swzhangf/AERIS-10-Open-Source-Pulse-Linear-Frequency-Modulated-Phased-Array-Radar/4_Schematics and Boards Layout/4_7_Production Files/PCBWay_Impedance_Note_RO4350B_h0p102mm.pdf

# Controlled Impedance Note — RO4350B (h = 0.102

mm)

## Stackup Details

- Material: Rogers RO4350B
- Dielectric constant (Design Dk): 3.66 (diff-phase method)
- Dielectric constant (Process Dk): 3.48 ± 0.05 (IPC clamped)
- Dielectric thickness (h): 0.102 mm
- Copper thickness: 35 µm base, ~40–45 µm finished after plating
- Solder mask: None (maskless RF traces over air)
- Reference: Continuous ground plane directly beneath RF layer

## Targets

Differential pair (LVDS) | Zdiff = 100 Ω ± 8%
Single-ended reference | Z0 = 50 Ω ± 10%

## Starting Geometry (maskless microstrip)

Values are starting points for PCBWay CAM to field-solve and tune with coupons.

Assumption | 50 Ω microstrip (w, mm) | 100 Ω diff pair (w, mm) | 100 Ω diff pair (s edge-edge, mm)
Process Dk = 3.48 | 0.204 | 0.204 | 0.26
Design Dk = 3.66 | 0.195 | 0.195 | 0.26

## Alternate Option (keep w = 0.204 mm; adjust gap for Design Dk)

Assumption | w (mm) | s edge-edge (mm) | Expected Zdiff
Design Dk = 3.66 | 0.204 | 0.30 | ≈ 100–102 Ω

## Routing Rules

- Continuous reference plane; no splits/slots beneath the pair
- Point-to-point routing; no stubs or tees; equal via count per leg
- Intra-pair length match: ≤ 1–2 mm for 10.5 GHz RF; ≤ 5 mm for LVDS clocks
- No same-layer ground pour near the pair unless re-solved for CPWG
- If via fencing is used: via-center to outer trace edge ≈ 0.5 mm; pitch ≤ 1.0 mm; symmetric on both sides
- Receiver termination: 100 Ω differential (omit external if receiver provides internal 100 Ω)

## Coupon/Test Notes

- Provide impedance coupons for both 50 Ω microstrip and 100 Ω differential pair
- PCBWay may tune w by ±0.02–0.04 mm and/or s by ±0.03–0.05 mm to hit targets
- Return as-built geometry values (w, s) in the fab report
