swzhangf/AERIS-10-Open-Source-Pulse-Linear-Frequency-Modulated-Phased-Array-Radar/4_Schematics and Boards Layout/4_6_Schematics/Antennas/Patch/8x16/Design 8x16 at 10.5GHz.docx

Design 8x16 at 10.5 GHz

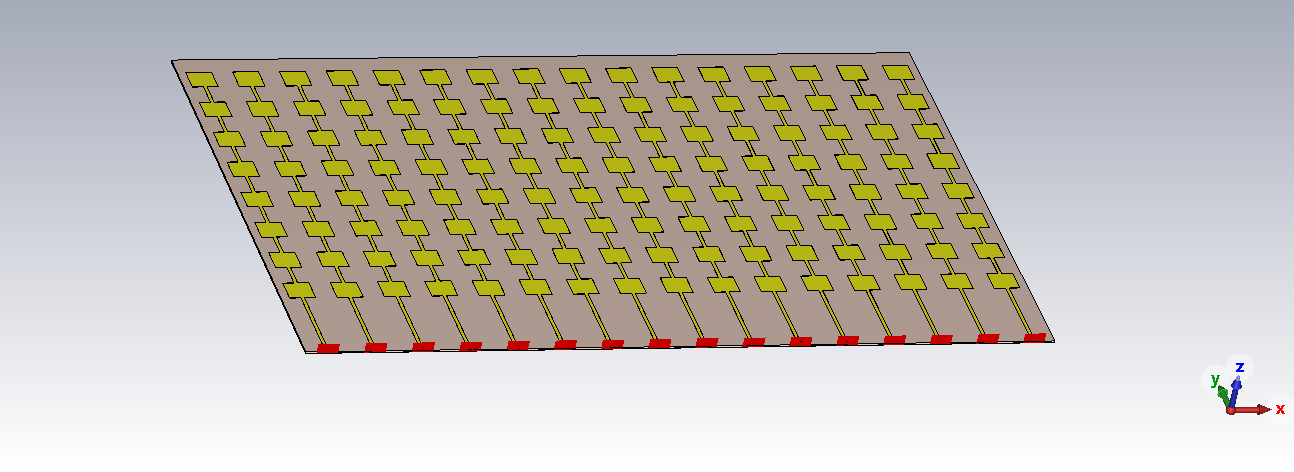
[picture p15: figure]

Working Frequency 10.5 GHz

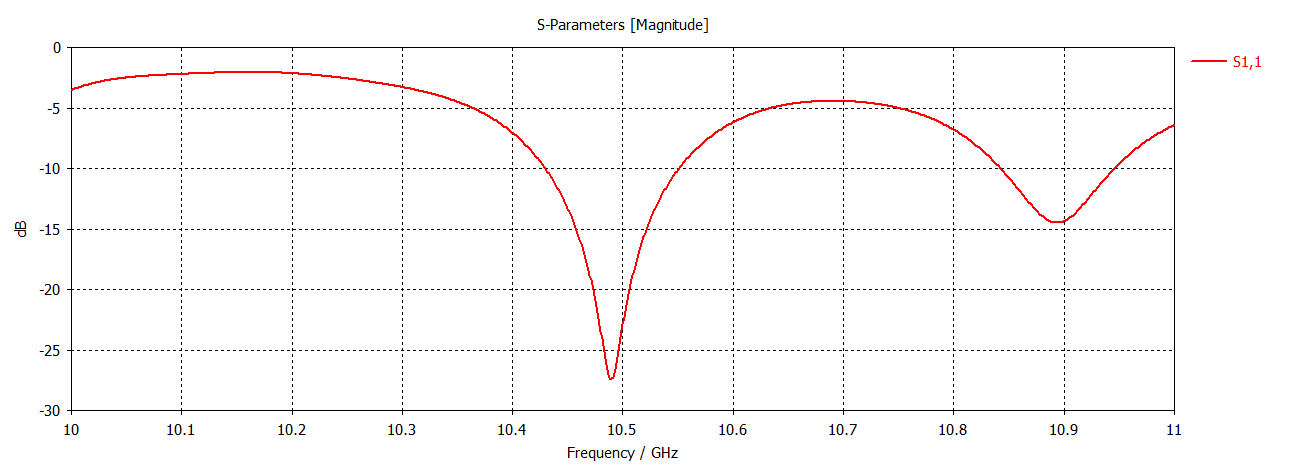
[picture p16: figure]

Gain 24.3 dBi

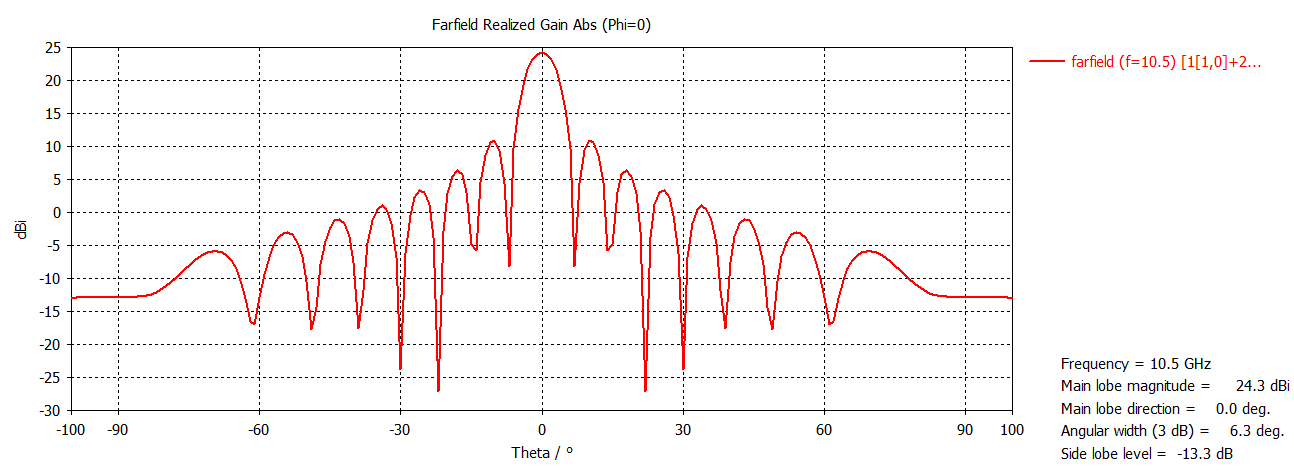
[picture p17: figure]
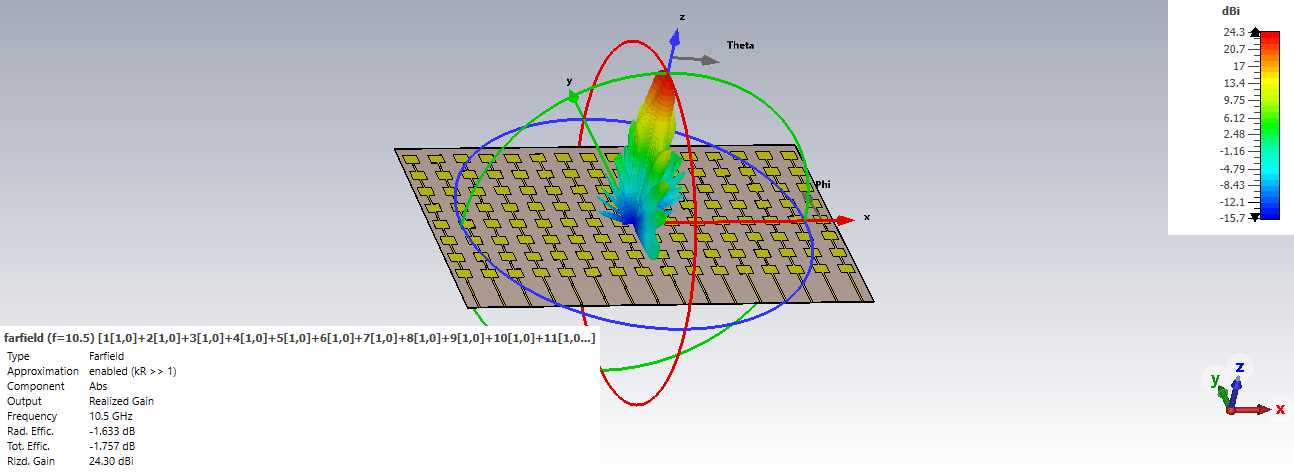
[picture p18: figure]
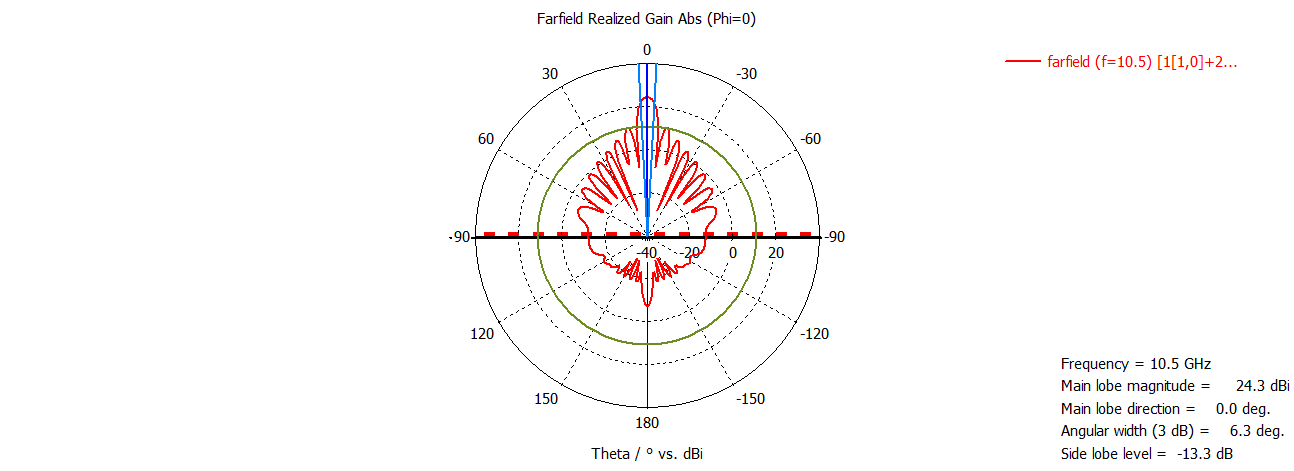
[picture p19: figure]
