swzhangf/AERIS-10-Open-Source-Pulse-Linear-Frequency-Modulated-Phased-Array-Radar/5_Simulations/Sim_BPF_Te_100um/Sim_BPF_Te_100um.pdf

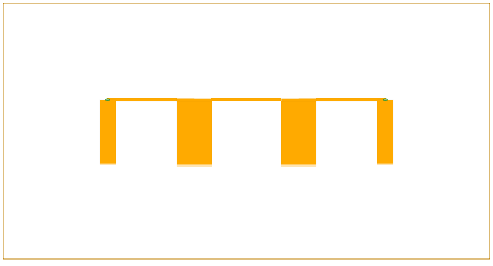
[picture p20: figure]
