swzhangf/AERIS-10-Open-Source-Pulse-Linear-Frequency-Modulated-Phased-Array-Radar/4_Schematics and Boards Layout/4_4_Board Stack-up/Stack_Hybrid.png

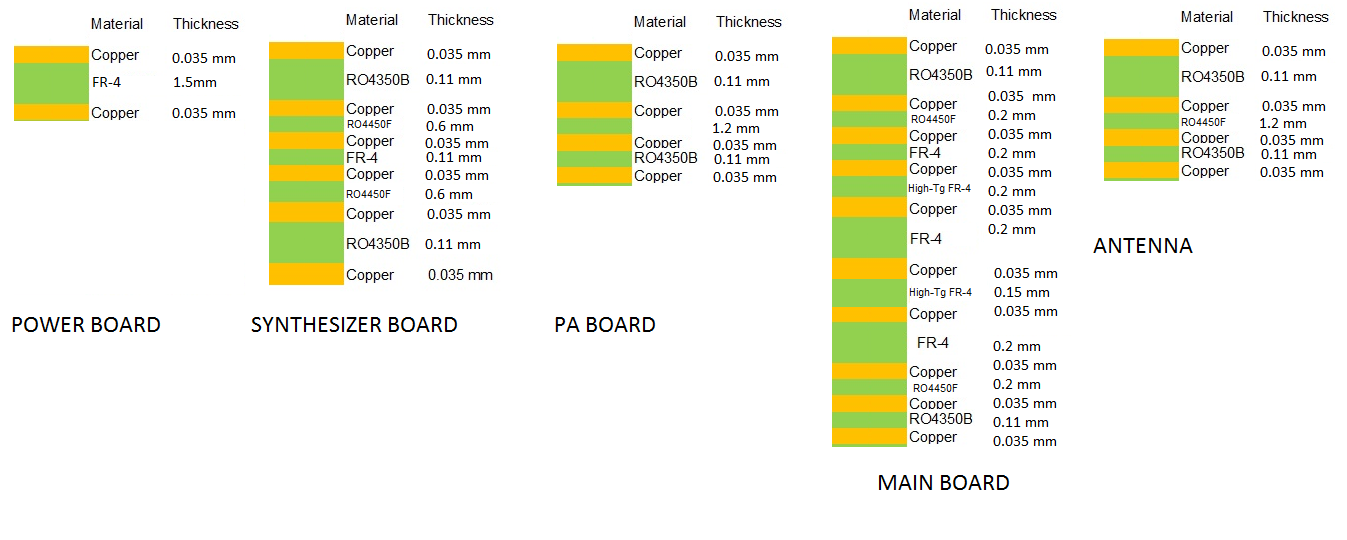
4_Schematics and Boards Layout/4_4_Board Stack-up/Stack_Hybrid.png
