swzhangf/AERIS-10-Open-Source-Pulse-Linear-Frequency-Modulated-Phased-Array-Radar/4_Schematics and Boards Layout/4_6_Schematics/Stack_Hybrid.png

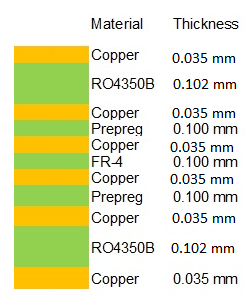
4_Schematics and Boards Layout/4_6_Schematics/Stack_Hybrid.png
