swzhangf/AERIS-10-Open-Source-Pulse-Linear-Frequency-Modulated-Phased-Array-Radar/5_Simulations/array_pattern_heatmap.png

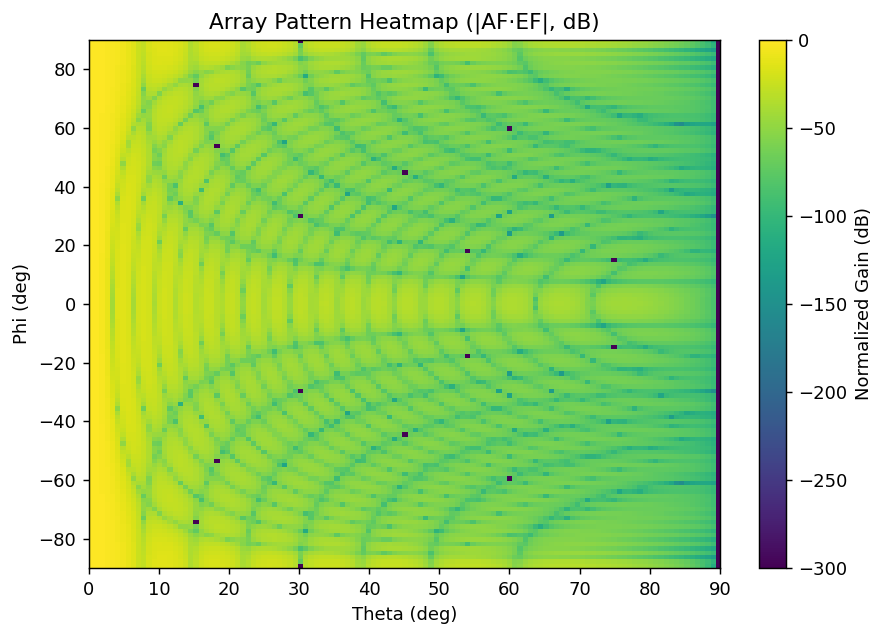
5_Simulations/array_pattern_heatmap.png
