swzhangf/AERIS-10-Open-Source-Pulse-Linear-Frequency-Modulated-Phased-Array-Radar/5_Simulations/H_plane_cut.png

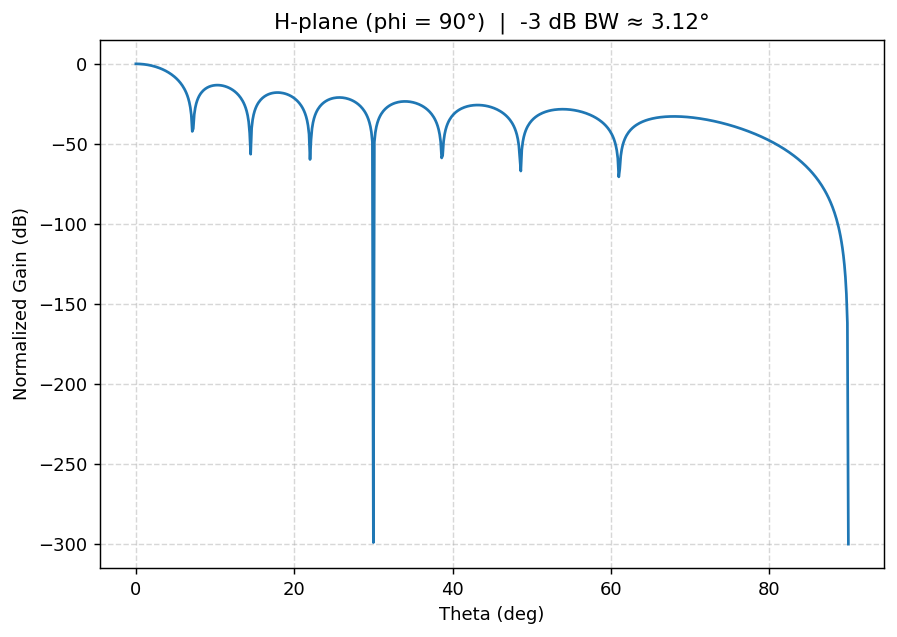
5_Simulations/H_plane_cut.png
