swzhangf/AERIS-10-Open-Source-Pulse-Linear-Frequency-Modulated-Phased-Array-Radar/8_Utils/3fb1dabf-2c6d-4b5d-b471-48bc461ce914.jpg

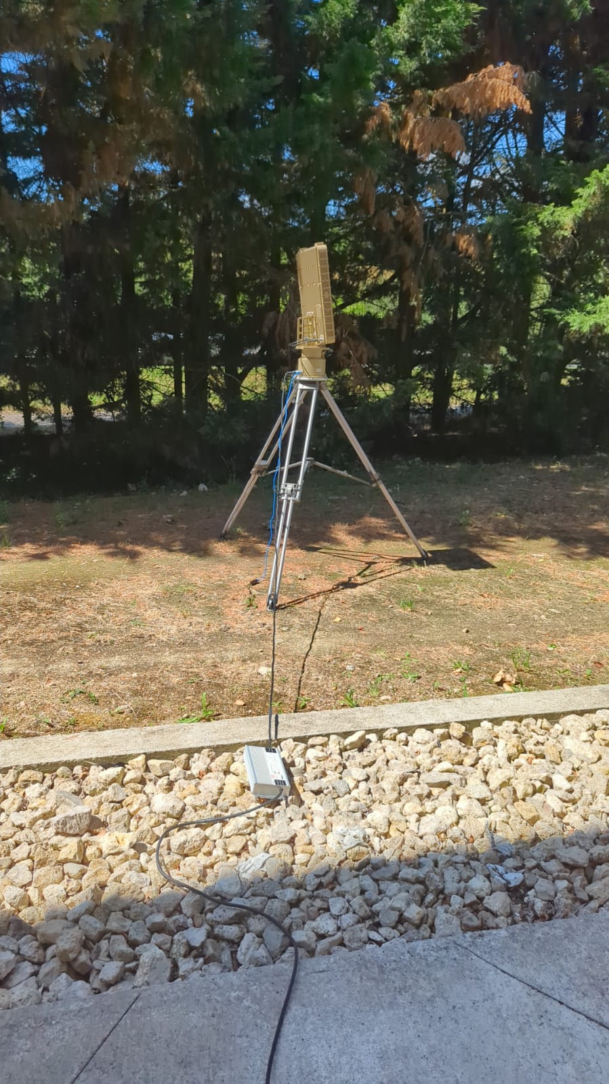
8_Utils/3fb1dabf-2c6d-4b5d-b471-48bc461ce914.jpg
