swzhangf/AERIS-10-Open-Source-Pulse-Linear-Frequency-Modulated-Phased-Array-Radar/8_Utils/b79a6fe3-5abf-473d-b3e2-178e6a9cf4da - Copie.jpg

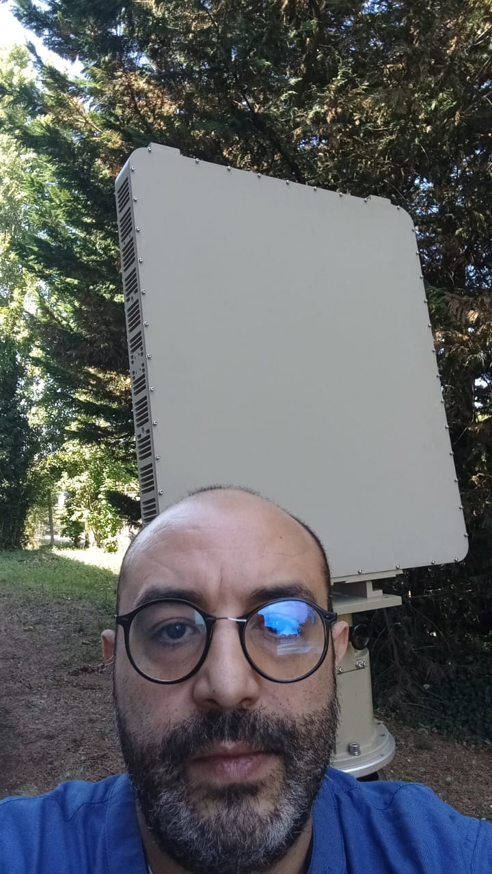
8_Utils/b79a6fe3-5abf-473d-b3e2-178e6a9cf4da - Copie.jpg
