swzhangf/AERIS-10-Open-Source-Pulse-Linear-Frequency-Modulated-Phased-Array-Radar/8_Utils/PCBWAY.jpg

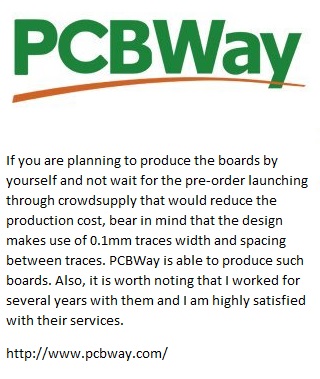
8_Utils/PCBWAY.jpg
