swzhangf/AERIS-10-Open-Source-Pulse-Linear-Frequency-Modulated-Phased-Array-Radar/4_Schematics and Boards Layout/4_7_Production Files/Gerber_PA/BOM.xlsx

Qty | Value | Device | Package | Parts | Description | MANUFACTURER_PART_NUMBER | MPN | OC_FARNELL | OC_NEWARK
1 |  | AK300/2 | AK300/2 | 22V | CONNECTOR |  |  | unknown | unknown
6 | 0.1µF | C-EUC0402 | C0402 | C2, C3, C6, C7, C8, C9 | CAPACITOR, European symbol
6 | 0R | R-EU_R0402 | R0402 | R2, R3, R5, R7, R8, R9 | RESISTOR, European symbol
1 | 0R | R-EU_R0603 | R0603 | R6 | RESISTOR, European symbol
2 | 10R | R-EU_R0402 | R0402 | R1, R4 | RESISTOR, European symbol
3 | 10µF | C-EUC1206 | C1206 | C1, C4, C5 | CAPACITOR, European symbol
2 | 142-0731-211 | 142-0731-211 | 1420731211 | J1, J2 | SMA Connector Jack, Female Socket 50 Ohms Through Hole Solder | 142-0731-211
1 | 22-23-2021 | 22-23-2021 | 22-23-2021 | X2 | .100 (2.54mm) Center Header - 2 Pin" |  | 22-23-2021 | 1462926 | 25C3832
1 | 22-23-2031 | 22-23-2031 | 22-23-2031 | X3 | .100 (2.54mm) Center Header - 3 Pin" |  | 22-23-2031 | 1462950 | 30C0862
1 | 5mR | WSL2816R1000FEH | WSL2816_VIS | R10 |  | WSL2816R1000FEH
1 | QPA2962_B | QPA2962_B | QPA2962_B | U$1
