swzhangf/AERIS-10-Open-Source-Pulse-Linear-Frequency-Modulated-Phased-Array-Radar/4_Schematics and Boards Layout/4_7_Production Files/Gerber_PowerBoard/BOM.xlsx

Sheet: Feuil1
DESIGNATOR | Qty | *Mfg Part # | Value | Device | Package | Description | DESCRIPTION |  |  |  |  |  |  |  |  | unknown | unknown | 16
X1 | 1 |  |  | AK300/2 | AK300/2 | CONNECTOR |  |  |  |  |  |  |  |  |  | unknown | unknown | 3
SV1 | 1 |  |  | MA10-2 | MA10-2 | PIN HEADER |  |  |  |  |  |  |  |  |  |  |  | 88 |  | C
C1, C6, C12, C18, C29, C30, C36, C42, C54, C60, C66, C71, C76, C77, C83, C89, C109, C119, C129, C144, C154 | 21 |  | 0.1µF | C-EUC0805 | C0805 | CAPACITOR, European symbol |  |  |  |  |  |  |  |  |  |  |  | 45 |  | R
R2, R4, R6, R8, R10, R12, R14, R16, R18, R20, R22, R24, R26, R28, R30, R32, R34, R36, R38, R40, R42, R44, R46, R48, R50, R52, R56 | 27 |  | 10k | R-EU_M0805 | M0805 | RESISTOR, European symbol |  |  |  |  |  |  |  |  |  |  |  | 73 |  | C
C150, C152, C160, C162 | 4 |  | 10nF | C-EUC0603 | C0603 | CAPACITOR, European symbol |  |  |  |  |  |  |  |  |  |  |  | 73 |  | C
C151, C153, C161, C163 | 4 |  | 10µF | C-EUC0603 | C0603 | CAPACITOR, European symbol |  |  |  |  |  |  |  |  |  |  |  | 88 |  | C
C4, C5, C9, C10, C15, C16, C21, C22, C24, C25, C28, C33, C34, C39, C40, C45, C46, C50, C51, C52, C53, C57, C58, C63, C64, C69, C70, C74, C75, C80, C81, C86, C87, C92, C93, C94, C95, C108, C112, C113, C114, C115, C118, C122, C123, C124, C125, C128, C132, C133, C134, C135, C138, C139, C140, C143, C147, C148, C157, C158 | 60 |  | 10µF | C-EUC0805 | C0805 | CAPACITOR, European symbol |  |  |  |  |  |  |  |  |  |  |  | 45 |  | R
R54, R58 | 2 |  | 11.5k | R-EU_M0805 | M0805 | RESISTOR, European symbol |  |  |  |  |  |  |  |  |  |  |  | 45 |  | R
R9, R35, R43, R47 | 4 |  | 12k | R-EU_M0805 | M0805 | RESISTOR, European symbol |  |  |  |  |  |  |  |  |  |  |  | 45 |  | R
R3 | 1 |  | 13.7k | R-EU_M0805 | M0805 | RESISTOR, European symbol |  |  |  |  |  |  |  |  |  |  |  | 88 |  | C
C26, C27, C106, C107, C116, C117, C126, C127, C136, C137, C141, C142 | 12 |  | 1µF | C-EUC0805 | C0805 | CAPACITOR, European symbol
U$1, U$2 | 2 |  | 2.2µH | POWER_INDUCTOR | IND_VLP8040T-1R0N_TDK |  |  |  |  |  | MOLEX |  |  |  | 22-23-2021 | 1462926 | 25C3832 | 40
X2, X3, X4, X5, X6, X7, X8, X9, X10, X11, X12, X13, X14, X15, X16, X17, X18, X19, X20, X21, X22, X23, X24, X25, X26, X27, X28, X29, X30, X31, X32, X33, X34, X35, X36 | 35 |  | 22-23-2021 | 22-23-2021 | 22-23-2021 | .100 (2.54mm) Center Header - 2 Pin" |  |  |  |  |  |  |  |  |  |  |  | 73 |  | C
C2, C3, C7, C8, C11, C13, C14, C17, C19, C20, C23, C31, C32, C35, C37, C38, C41, C43, C44, C47, C48, C49, C55, C56, C59, C61, C62, C65, C67, C68, C72, C73, C78, C79, C82, C84, C85, C88, C90, C91, C110, C111, C120, C121, C130, C131, C145, C146, C149, C155, C156, C159 | 52 |  | 22µF | C-EUC0603 | C0603 | CAPACITOR, European symbol |  |  |  |  |  |  |  |  |  |  |  | 45 |  | R
R49 | 1 |  | 23.4k | R-EU_M0805 | M0805 | RESISTOR, European symbol |  |  |  |  |  |  |  |  |  |  |  | 45 |  | R
R39 | 1 |  | 2k | R-EU_M0805 | M0805 | RESISTOR, European symbol |  |  |  |  |  |  |  |  |  |  |  | 45 |  | R
R1 | 1 |  | 3.09k | R-EU_M0805 | M0805 | RESISTOR, European symbol
U$3, U$4, U$5, U$6, U$7, U$8, U$9, U$10, U$11, U$12, U$13, U$14, U$15, U$16, U$17, U$18, U$19, U$20, U$21 | 19 |  | 3.3µH | POWER_INDUCTOR | IND_VLP8040T-1R0N_TDK |  |  |  |  |  |  |  |  |  |  |  |  | 45 |  | R
R5, R7, R11, R13, R15, R19 | 6 |  | 32.2k | R-EU_M0805 | M0805 | RESISTOR, European symbol |  |  |  |  |  |  |  |  |  |  |  | 45 |  | R
R21 | 1 |  | 34.8k | R-EU_M0805 | M0805 | RESISTOR, European symbol |  |  |  |  |  |  |  |  |  |  |  | 45 |  | R
R53, R57 | 2 |  | 35.7k | R-EU_M0805 | M0805 | RESISTOR, European symbol |  |  |  |  |  |  |  |  |  |  |  | 45 |  | R
R17, R23, R25, R27, R29, R31, R37, R41, R45, R51, R55 | 11 |  | 56.2k | R-EU_M0805 | M0805 | RESISTOR, European symbol |  |  |  |  |  |  |  |  |  |  |  | 45 |  | R
R33 | 1 |  | 61.9k | R-EU_M0805 | M0805 | RESISTOR, European symbol |  |  | Analog Devices Inc | ADM7151ACPZ-04-R7
U5, U23, U25, U27, U29, U30 | 6 |  | ADM7151ACPZ-04-R7 | ADM7151ACPZ-04-R7 | CP_8_11_ADI |  | 800 mA Ultralow Noise, High PSRR, RF Linear Regulator |  |  | LM2662MX/NOPB |  | Texas Instruments |  |  |  |  |  |  |  |  | LM2662M
U18, U19, U20, U21, U22 | 5 |  | LM2662MX/NOPB | LM2662MX/NOPB | M08A |  |  | 1.5mm | KEMET | T521W476M020ATE045 |  |  | 80-T521W476M20ATE045 | https://www.mouser.co.uk/ProductDetail/KEMET/T521W476M020ATE045?qs=Ad%252Bh9aq9FyVtchBw1jwoFA%3D%3D
C96, C97, C98, C99, C100, C101, C102, C103, C104, C105 | 10 |  | T521W476M020ATE045 | T521W476M020ATE045 | T521W | T521, Tantalum, Polymer Tantalum, Commercial Grade, 47 uF, 20%, 20 VDC, 105C, -55C, 105C, SMD, Polymer, Molded, Low Profile/ESR, NonCombustible, 2,000 Hrs, 9 % , 45 mOhms, 94 uA, 222.95 mg, 7343, 1.4mm, Height Max = 1.5mm, 1000, 52 Weeks | T521, Tantalum, Polymer Tantalum, Commercial Grade, 47 uF, 20%, 20 VDC, 105C, -55C, 105C, SMD, Polymer, Molded, Low Profile/ESR, NonCombustible, 2,000 Hrs, 9 % , 45 mOhms, 94 uA, 222.95 mg, 7343, 1.4mm, Height Max = 1.5mm, 1000, 52 Weeks |  | Texas Instruments | TPS562208DDCT |  |  |  |  |  |  |  |  | RefDes |  | TYPE
U1, U2, U3, U4, U6, U7, U8, U9, U10, U11, U12, U13, U14, U15, U16, U17, U24, U26, U28, U31, U33 | 21 |  | TPS562208DDCT | TPS562208DDCT | DDC0006A_N |  | 4.5 V to 17 V input, 2 A output, synchronous step-down converter in FCCM mode 6-SOT-23-THIN -40 to 125 |  | Texas Instruments | TPS7A8300RGRR
U32, U34 | 2 |  | TPS7A8300RGRR | TPS7A8300RGRR | RGR20_2P05X2P05_TEX |  | 2-A, low-VIN, low-2-A, low-VIN, low-noise, ultra-low-dropout voltage regulator with power good wi 20-VQFN -40 to 125

Sheet: Feuil2
Item # | *Designator | *Qty | Manufacturer | *Mfg Part # | Description / Value | *Package/Footprint | Type | Your Instructions / Notes | HEIGHT | MANUFACTURER_NAME | MANUFACTURER_PART_NUMBER | MF | MFR_NAME | MOUSER_PART_NUMBER | MOUSER_PRICE-STOCK | MPN | OC_FARNELL | OC_NEWARK | POPULARITY | REFDES | SPICEPREFIX | TYPE
