swzhangf/AERIS-10-Open-Source-Pulse-Linear-Frequency-Modulated-Phased-Array-Radar/5_Simulations/Sim_BPF_Te_100um/Drawing1.dxf

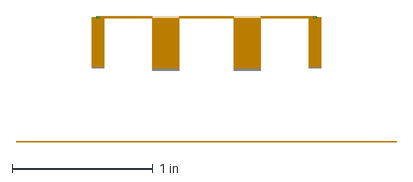
[picture p33: CAD file, 2026-04-20]
5_Simulations/Sim_BPF_Te_100um/Drawing1.dxf
2.70 x 0.892 in
