swzhangf/AERIS-10-Open-Source-Pulse-Linear-Frequency-Modulated-Phased-Array-Radar/(list of files, cad)

Other CAD files:
4_Schematics and Boards Layout/4_6_Schematics/Antennas/Waveguide/DFSWA.dwg
8_Utils/Mechanical_Drawings/Enclosure.dwg
8_Utils/Mechanical_Drawings/RADAR_V1.dwg
