swzhangf/AERIS-10-Open-Source-Pulse-Linear-Frequency-Modulated-Phased-Array-Radar/4_Schematics and Boards Layout/4_6_Schematics/Antennas/Waveguide/Dielectric_Filled_Waveguide_Array_Spec.docx

# Dielectric-Filled Waveguide Phased Array Antenna — Specifications & Deliverables

Date: 2025-08-13 | Version: 1.0 | Prepared by: Nawfal MOTII

# Project Overview

High-power, dielectric-filled rectangular waveguide phased array antenna for X-band operation. The array comprises 16 parallel waveguide columns, each with 32 longitudinal slots (travelling wave architecture), separated at λ₀/2 to enable ±60° electronic steering across columns. High purity alumina (Al₂O₃, 99.5–99.8%) is used as the dielectric fill to reduce cross section while maintaining low loss and robust thermal performance.

# Key Specifications (Customer Inputs)

Operating Frequency (f₀) | 10.5 GHz
Array Topology | 16 columns × 32 slots/column (travelling‑wave, terminated)
Inter‑column Pitch (dᵧ) | λ₀/2 ≈ 14.28 mm at 10.5 GHz
Dielectric Material | High‑purity alumina (Al₂O₃, 99.5–99.8%)
Microwave Power | 15 W per column (total 240 W)
Feed Type | 16 SMA connectors (one per waveguide column)
Total Gain (broadside) | ≥ 31 dBi
Electronic Steering Range | ±60° (across waveguide columns)

# Derived / Recommended Specifications

Free‑space wavelength (λ₀) | 28.55 mm
Guide cross‑section (internal) | a = 8.5 mm, b = 3.5 mm (alumina‑filled)
TE₁₀ cutoff (f_c10) | 5.63 GHz
Higher-order cutoffs | TE₂₀ ≈ 11.27 GHz, TE₀₁ ≈ 13.68 GHz (both > 10.5 GHz)
Guide wavelength (λ_g) | 10.81 mm
Slot spacing (s = λ_g/2) | 5.40 mm
Starter slot length (L_s≈0.47λ_g) | 5.08 mm
Column length (32 slots incl. margins) | 0.173 m
Panel height (16 columns) | 0.223 m
Geometric aperture (A=L·H) | 0.0385 m²
Ideal directivity | 27.73 dBi
EIRP at 240 W, G=31 dBi | 54.8 dBW

# Electrical Performance Targets

- Return loss (S₁₁) per column: ≤ −12 dB at 10.5 GHz; ≤ −10 dB across 10.25–10.75 GHz.
- Gain (boresight): ≥ 31 dBi; design goal 31–32 dBi with Taylor −25 dB taper.
- Sidelobe level (broadside, both principal planes): ≤ −23 dB (goal ≤ −25 dB).
- Cross‑polarization: ≤ −20 dB within main beam (goal ≤ −25 dB).
- Scan performance across columns: continuous scan to ±60°; scan loss ≤ 2 dB at 60°.
- Polarization: Linear
- Input impedance per column: nominal 50 Ω at feed; probe placed ≈ λ_g/4 from short.
- Phase shifter resolution recommendation: ≤ 5.6° LSB (≈ 1° angle steps near boresight).

# Mechanical & Materials

- Waveguide body: aluminum or copper alloy split-block; internal a=8.5 mm, b=3.5 mm (dielectric-filled).
- Dielectric: high-purity alumina (Al₂O₃ 99.5–99.8%); full fill or partial sidewall slabs (per EM optimization).
- Connectors: 16× SMA female bulkhead (power rated at X band); one per column.
- Feed geometry: coax probe feed located ≈ λ_g/4 from shorted back wall, centered (or tuned offset) in y.
- Manufacturing tolerances: slot length ±0.05 mm; slot offset ±0.03 mm; slot center position ±0.05 mm; flatness per length ≤ 0.05 mm/100 mm.
- Surface finish: Ra ≤ 1.6 µm in the RF volume; deburr and radius sharp edges.
- Optional plating: silver or electroless nickel (ENIG) as agreed; document any thickness effects.
- Optional pressurization: dry air/N₂ up to 1–2 bar for breakdown margin (include seals if required).

# Thermal & Power

- Per column CW power: 15 W; total 240 W distributed across 16 columns.
- Continuous operation over ambient −20 °C to +60 °C (goal; to be confirmed).
- Internal temperature rise limited such that dielectric and adhesives remain within ratings (supplier datasheets).

# Interfaces & Control

- RF inputs: 16 SMA female bulkhead connectors, 50 Ω.
- Beam steering: progressive phase per column (external phase shifters on customer PCB).
- Reference coordinate system and connector numbering: as per final assembly drawing.

# Verification & Test (Acceptance Criteria)

- VNA measurements: S₁₁ per column and inter column over 9–12 GHz; provide plots and Touchstone (.sNp/.s2p) and CSV.
- Anechoic chamber: boresight gain and 2D patterns at 10.3/10.5/10.7 GHz; provide polar plots and CSV.
- Scan patterns: measured principal plane cuts at θ = 0°, ±30°, ±45°, ±60° with specified phase sets; CSV exports.
- Near field to far field transform acceptable if chamber size limits; include processing details.
- Power run: operate at 15 W/column CW for 30 minutes; verify no arcing, no detuning beyond specs.
- Dimensional inspection: slot length/offset/spacing, column pitch, connector positions per tolerances.

# Deliverables

- Final 3D CAD: STEP (.stp) and/or Parasolid (.x_t); panel assembly and split‑block parts.
- 2D manufacturing drawings (PDF + native CAD) with full dimensions and tolerances.
- DXF/DWG: slot patterns, connector hole locations, and any gasket/seal cutouts.
- Materials list / BOM: metals, dielectric (alumina), fasteners, plating, adhesives, gaskets, finishes.
- EM simulation package: project files (HFSS/CST), simulation settings, and parametric studies.
- Simulation results: • S‑parameters 9–12 GHz (plots + Touchstone + CSV) • Input impedance 9–12 GHz (plots + CSV) • Surface current distributions at 10.5 GHz (images + data) • Far‑field patterns at θ = 0°, ±30°, ±45°, ±60° (plots + CSV)
- Slot synthesis tables: per‑column slot centers, lengths, and offsets (CSV).
- Assembly instructions and tuning plan (if any trim adjustments are foreseen).
- Qualification / acceptance test report with measured data and comparison to targets.
