swzhangf/AERIS-10-Open-Source-Pulse-Linear-Frequency-Modulated-Phased-Array-Radar/5_Simulations/Fencing/via_fence_setup_pitch_offset.png

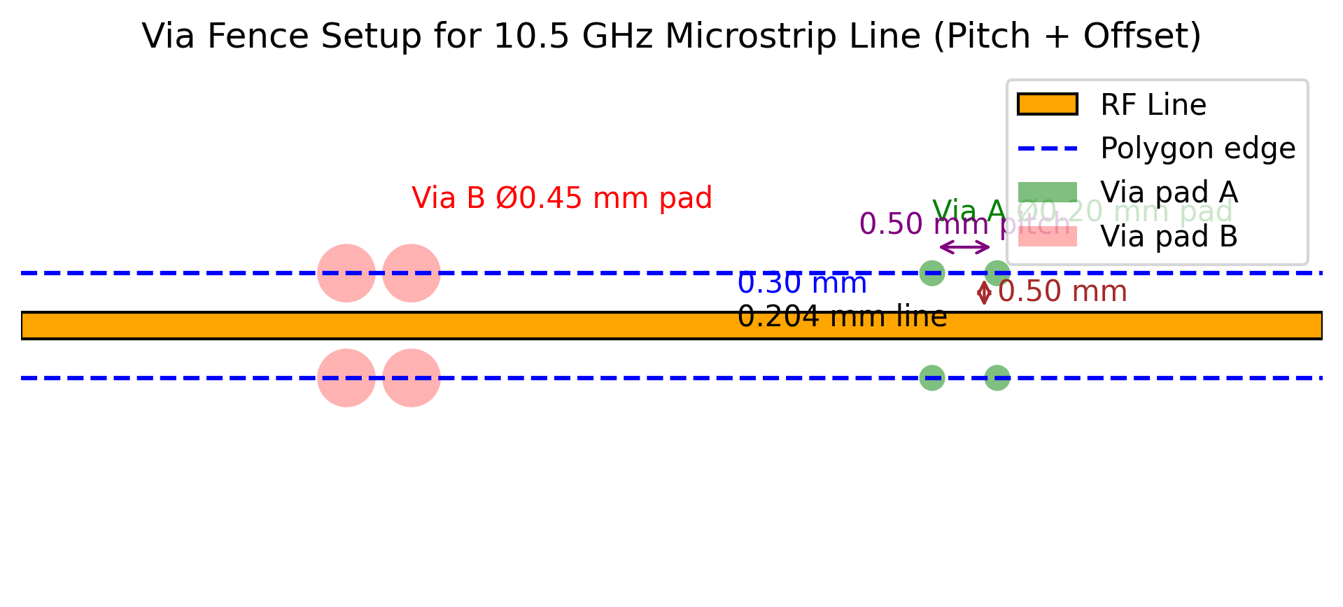
5_Simulations/Fencing/via_fence_setup_pitch_offset.png
