swzhangf/AERIS-10-Open-Source-Pulse-Linear-Frequency-Modulated-Phased-Array-Radar/8_Utils/Python/small_test_radar_data.csv

timestamp_ns | chirp_number | chirp_type | sample_index | I_value | Q_value | magnitude_squared
0 | 0 | LONG | 0 | -4 | 2 | 31
2 | 0 | LONG | 1 | 3 | -3 | 19
4 | 0 | LONG | 2 | 0 | 0 | 0
6 | 0 | LONG | 3 | -3 | 0 | 16
8 | 0 | LONG | 4 | -1 | -6 | 41
10 | 0 | LONG | 5 | 0 | 6 | 41
12 | 0 | LONG | 6 | -2 | 0 | 4
14 | 0 | LONG | 7 | -5 | 4 | 50
16 | 0 | LONG | 8 | 4 | -2 | 26
18 | 0 | LONG | 9 | 0 | -1 | 2
20 | 0 | LONG | 10 | 3 | 1 | 14
22 | 0 | LONG | 11 | 2 | -2 | 12
24 | 0 | LONG | 12 | -1 | 0 | 2
26 | 0 | LONG | 13 | 0 | -1 | 1
28 | 0 | LONG | 14 | -2 | 0 | 5
30 | 0 | LONG | 15 | 0 | 5 | 26
32 | 0 | LONG | 16 | -1 | 1 | 6
34 | 0 | LONG | 17 | -4 | 0 | 23
36 | 0 | LONG | 18 | 0 | 0 | 0
38 | 0 | LONG | 19 | -3 | -4 | 32
40 | 0 | LONG | 20 | -2 | 0 | 5
42 | 0 | LONG | 21 | 0 | -4 | 18
44 | 0 | LONG | 22 | -2 | 0 | 4
46 | 0 | LONG | 23 | 1 | -3 | 14
48 | 0 | LONG | 24 | 1 | -1 | 5
50 | 0 | LONG | 25 | 3 | 3 | 26
52 | 0 | LONG | 26 | 0 | 3 | 10
54 | 0 | LONG | 27 | -4 | -2 | 27
56 | 0 | LONG | 28 | 2 | 0 | 5
58 | 0 | LONG | 29 | 0 | -5 | 25
60 | 0 | LONG | 30 | -2 | 1 | 8
62 | 0 | LONG | 31 | 0 | 0 | 0
64 | 0 | LONG | 32 | -3 | -3 | 22
66 | 0 | LONG | 33 | 0 | 0 | 1
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
