swzhangf/AERIS-10-Open-Source-Pulse-Linear-Frequency-Modulated-Phased-Array-Radar/8_Utils/Python/test_radar_data.csv

timestamp_ns | chirp_number | chirp_type | sample_index | I_value | Q_value | magnitude_squared
0 | 0 | LONG | 0 | -15 | 16 | 499
2 | 0 | LONG | 1 | -12 | 17 | 484
4 | 0 | LONG | 2 | 0 | 9 | 94
6 | 0 | LONG | 3 | -12 | -8 | 228
8 | 0 | LONG | 4 | -2 | -4 | 26
10 | 0 | LONG | 5 | -10 | -2 | 124
12 | 0 | LONG | 6 | -4 | -13 | 195
14 | 0 | LONG | 7 | -3 | -5 | 44
16 | 0 | LONG | 8 | -12 | 14 | 356
18 | 0 | LONG | 9 | -3 | -5 | 40
20 | 0 | LONG | 10 | 0 | -8 | 76
22 | 0 | LONG | 11 | -11 | 26 | 846
24 | 0 | LONG | 12 | -7 | 1 | 53
26 | 0 | LONG | 13 | -10 | 10 | 216
28 | 0 | LONG | 14 | 3 | -3 | 27
30 | 0 | LONG | 15 | 21 | 8 | 517
32 | 0 | LONG | 16 | 17 | 3 | 317
34 | 0 | LONG | 17 | 15 | -5 | 279
36 | 0 | LONG | 18 | 29 | -1 | 886
38 | 0 | LONG | 19 | -16 | 0 | 268
40 | 0 | LONG | 20 | -6 | -9 | 129
42 | 0 | LONG | 21 | 0 | 0 | 0
44 | 0 | LONG | 22 | -5 | 1 | 30
46 | 0 | LONG | 23 | 12 | 11 | 300
48 | 0 | LONG | 24 | 10 | 1 | 116
50 | 0 | LONG | 25 | -5 | -14 | 255
52 | 0 | LONG | 26 | -2 | 3 | 18
54 | 0 | LONG | 27 | 0 | 11 | 135
56 | 0 | LONG | 28 | 9 | 19 | 466
58 | 0 | LONG | 29 | 15 | 6 | 280
60 | 0 | LONG | 30 | -13 | 4 | 187
62 | 0 | LONG | 31 | 2 | -8 | 76
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
