swzhangf/AERIS-10-Open-Source-Pulse-Linear-Frequency-Modulated-Phased-Array-Radar/(list of files, drawings)

Other design files:
5_Simulations/Sim_BPF_Te_100um/Sim_BPF_Te_100um.pcb
