swzhangf/AERIS-10-Open-Source-Pulse-Linear-Frequency-Modulated-Phased-Array-Radar/4_Schematics and Boards Layout/4_6_Schematics/MainBoard/RADAR_Main_Board.brd

## EAGLE design 4_Schematics and Boards Layout/4_6_Schematics/MainBoard/RADAR_Main_Board.brd (continued)

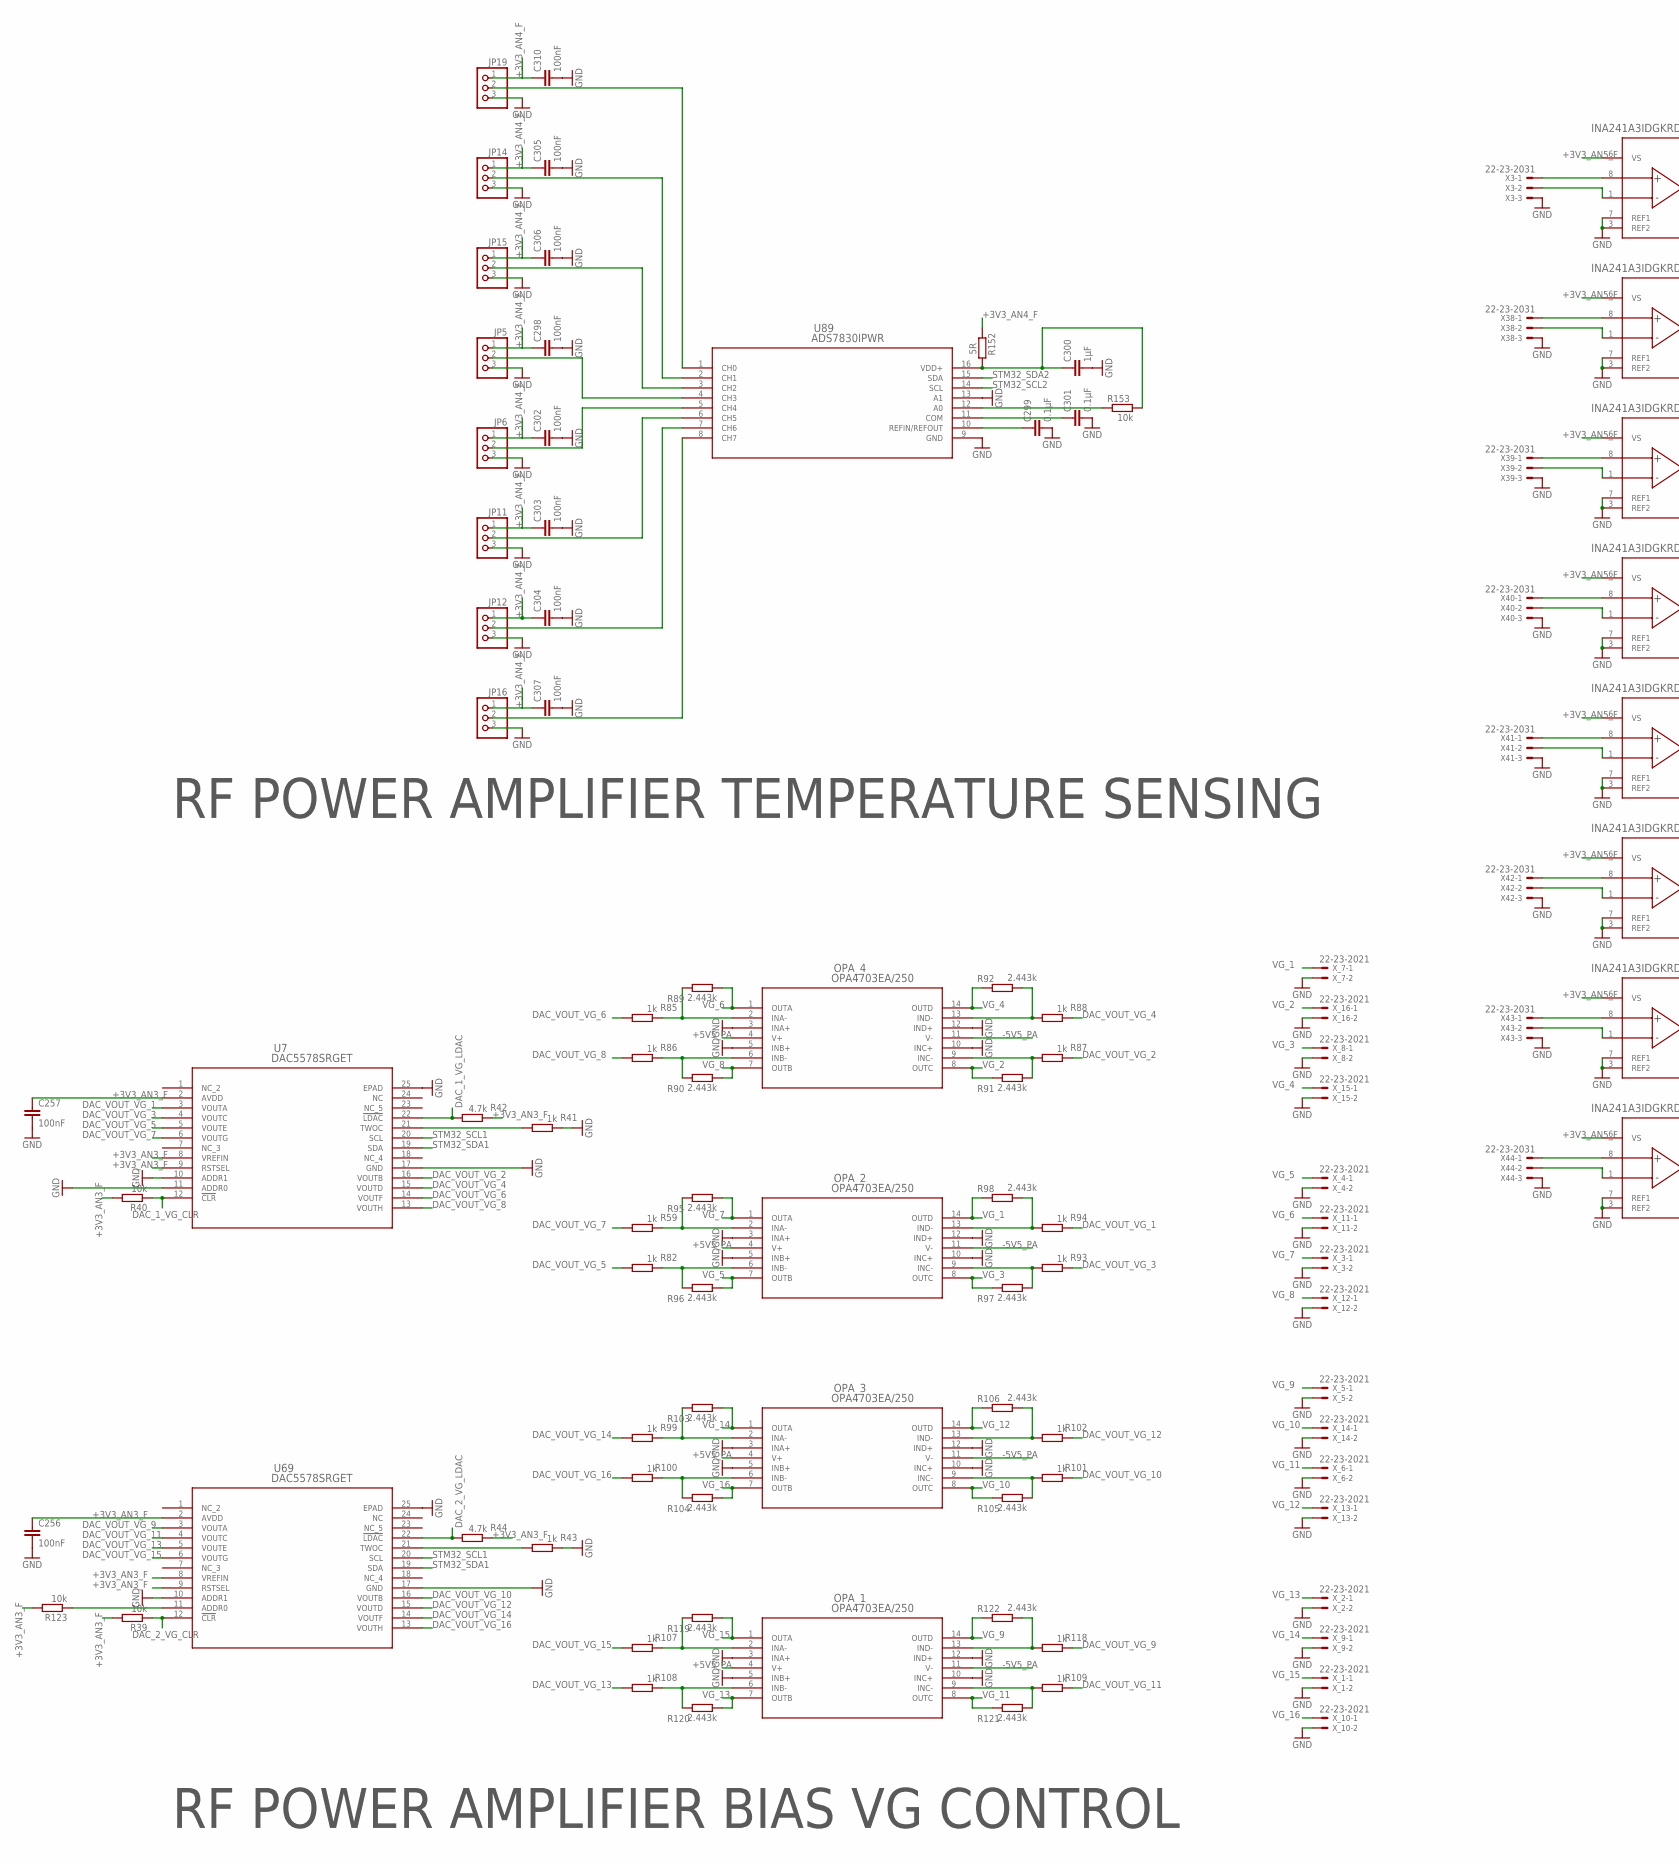
[picture p45: schematic RADAR_Main_Board.sch, sheet 4, RF POWER AMPLIFIER BIAS, part in row 1, column 1]

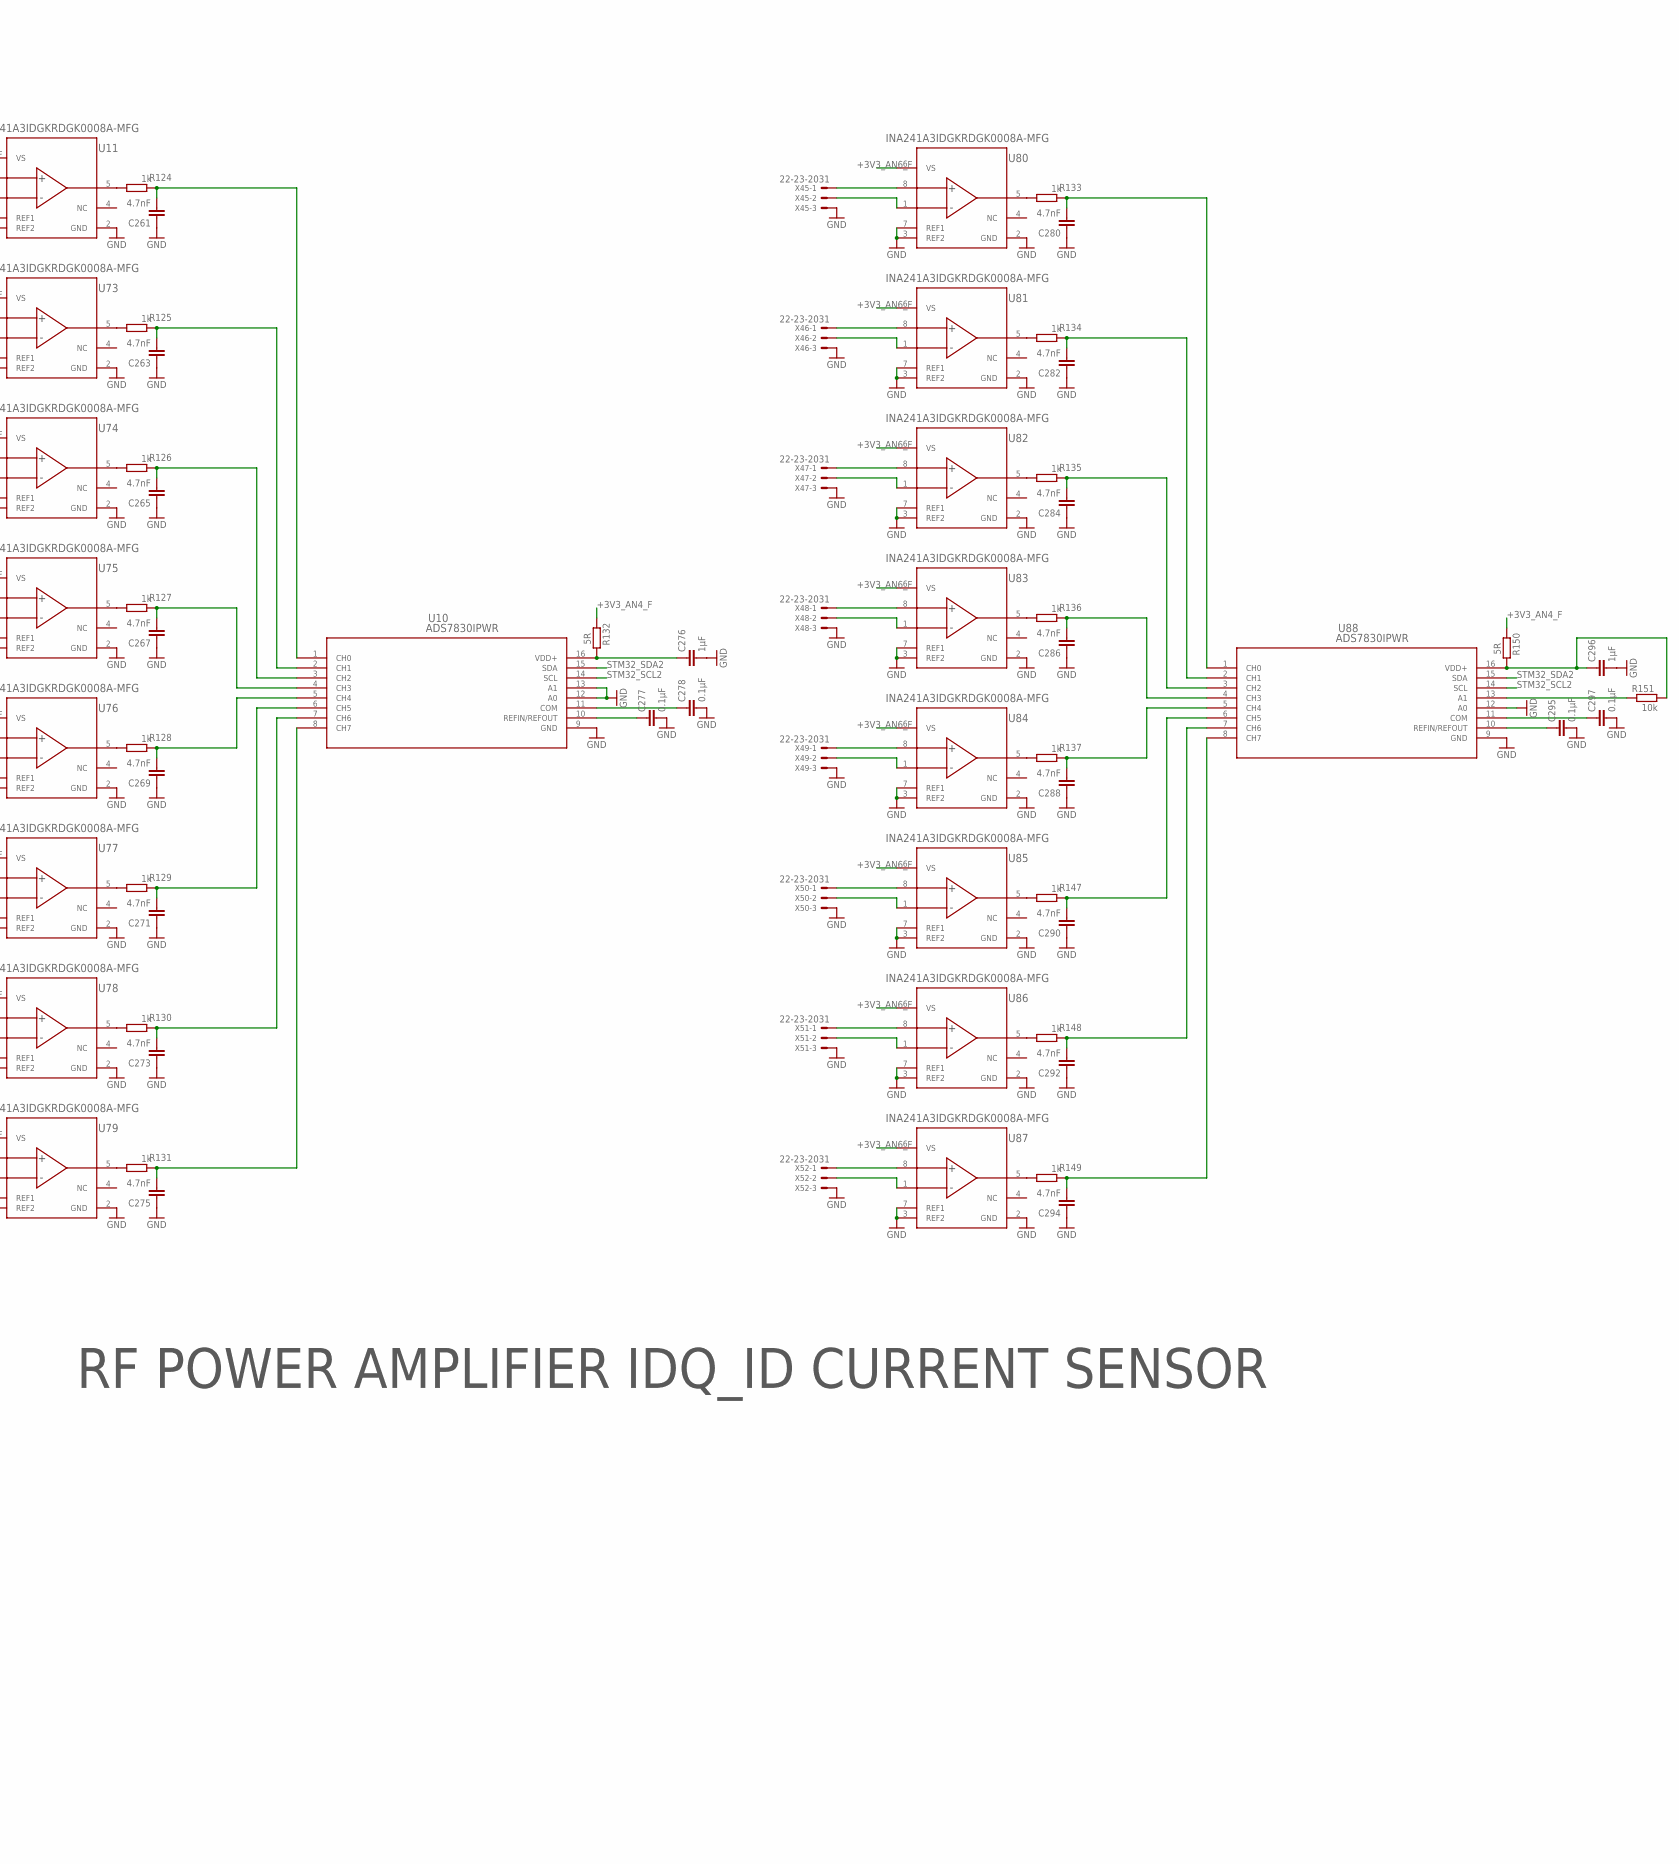
[picture p46: schematic RADAR_Main_Board.sch, sheet 4, RF POWER AMPLIFIER BIAS, part in row 1, column 2]

Parts:
C256, C257, C298, C302, C303, C304, C305, C306, C307, C310: 100nF; C0201
C261, C263, C265, C267, C269, C271, C273, C275, C280, C282, C284, C286, C288, C290, C292, C294: 4.7nF; C0201
C276, C296, C300: 1µF; C0201
C277, C278, C295, C297, C299, C301: 0.1µF; C0201
JP5, JP6, JP11, JP12, JP14, JP15, JP16, JP19: PINHD-1X3; 1X03
OPA_1, OPA_2, OPA_3, OPA_4: OPA4703EA/250; PW14
R39, R40, R123, R151, R153: 10k; R0201
R41, R43, R59, R82, R85, R86, R87, R88, R93, R94, R99, R100, R101, R102, R107, R108, R109, R118, R124, R125, R126, R127, R128, R129, R130, R131, R133, R134, R135, R136, R137, R147, R148, R149: 1k; R0201
R42, R44: 4.7k; R0201
R89, R90, R91, R92, R95, R96, R97, R98, R103, R104, R105, R106, R119, R120, R121, R122: 2.443k; R0201
R132, R150, R152: 5R; R0201
U7, U69: DAC5578SRGET; RGE24_2P7X2P7
U10, U88, U89: ADS7830IPWR; PW16
U11, U73, U74, U75, U76, U77, U78, U79, U80, U81, U82, U83, U84, U85, U86, U87: INA241A3IDGKRDGK0008A-MFG; DGK0008A-MFG
X3, X38, X39, X40, X41, X42, X43, X44, X45, X46, X47, X48, X49, X50, X51, X52: 22-23-2031
X_1, X_2, X_3, X_4, X_5, X_6, X_7, X_8, X_9, X_10, X_11, X_12, X_13, X_14, X_15, X_16: 22-23-2021

Connections:
+3V3_AN3_F: C256.1, C257.1, R39.2, R40.2, R42.1, R44.1, R123.2, U7.2 (AVDD), U7.8 (VREFIN), U7.9 (RSTSEL), U69.2 (AVDD), U69.8 (VREFIN), U69.9 (RSTSEL); also elsewhere on the board
+3V3_AN4_F: C298.1, C302.1, C303.1, C304.1, C305.1, C306.1, C307.1, C310.1, JP5.1, JP6.1, JP11.1, JP12.1, JP14.1, JP15.1, JP16.1, JP19.1, R132.1, R150.1, R152.1; also elsewhere on the board
+3V3_AN5_F: U11.6 (VS), U73.6 (VS), U74.6 (VS), U75.6 (VS), U76.6 (VS), U77.6 (VS), U78.6 (VS), U79.6 (VS); also elsewhere on the board
+3V3_AN6_F: U80.6 (VS), U81.6 (VS), U82.6 (VS), U83.6 (VS), U84.6 (VS), U85.6 (VS), U86.6 (VS), U87.6 (VS); also elsewhere on the board
+5V5_PA: OPA_1.4 (V+), OPA_2.4 (V+), OPA_3.4 (V+), OPA_4.4 (V+); also elsewhere on the board
-5V5_PA: OPA_1.11 (V-), OPA_2.11 (V-), OPA_3.11 (V-), OPA_4.11 (V-); also elsewhere on the board
DAC_1_VG_CLR: R40.1, U7.12 (!CLR); also elsewhere on the board
DAC_1_VG_LDAC: R42.2, U7.22 (!LDAC); also elsewhere on the board
DAC_2_VG_CLR: R39.1, U69.12 (!CLR); also elsewhere on the board
DAC_2_VG_LDAC: R44.2, U69.22 (!LDAC); also elsewhere on the board
DAC_VOUT_VG_1: R94.1, U7.3 (VOUTA)
DAC_VOUT_VG_2: R87.1, U7.16 (VOUTB)
DAC_VOUT_VG_3: R93.1, U7.4 (VOUTC)
DAC_VOUT_VG_4: R88.1, U7.15 (VOUTD)
DAC_VOUT_VG_5: R82.2, U7.5 (VOUTE)
DAC_VOUT_VG_6: R85.2, U7.14 (VOUTF)
DAC_VOUT_VG_7: R59.2, U7.6 (VOUTG)
DAC_VOUT_VG_8: R86.2, U7.13 (VOUTH)
DAC_VOUT_VG_9: R118.1, U69.3 (VOUTA)
DAC_VOUT_VG_10: R101.1, U69.16 (VOUTB)
DAC_VOUT_VG_11: R109.1, U69.4 (VOUTC)
DAC_VOUT_VG_12: R102.1, U69.15 (VOUTD)
DAC_VOUT_VG_13: R108.2, U69.5 (VOUTE)
DAC_VOUT_VG_14: R99.2, U69.14 (VOUTF)
DAC_VOUT_VG_15: R107.2, U69.6 (VOUTG)
DAC_VOUT_VG_16: R100.2, U69.13 (VOUTH)
GND: C256.2, C257.2, C261.1, C263.1, C265.1, C267.1, C269.1, C271.1, C273.1, C275.1, C276.2, C277.2, C278.2, C280.1, C282.1, C284.1, C286.1, C288.1, C290.1, C292.1, C294.1, C295.2, C296.2, C297.2, C298.2, C299.2, C300.2, C301.2, C302.2, C303.2, C304.2, C305.2, C306.2, C307.2, C310.2, JP5.3, JP6.3, JP11.3, JP12.3, JP14.3, JP15.3, JP16.3, JP19.3, OPA_1.3 (INA+), OPA_1.5 (INB+), OPA_1.10 (INC+), OPA_1.12 (IND+), OPA_2.3 (INA+), OPA_2.5 (INB+), OPA_2.10 (INC+), OPA_2.12 (IND+), OPA_3.3 (INA+), OPA_3.5 (INB+), OPA_3.10 (INC+), OPA_3.12 (IND+), OPA_4.3 (INA+), OPA_4.5 (INB+), OPA_4.10 (INC+), OPA_4.12 (IND+), R41.1, R43.1, U7.10 (ADDR1), U7.11 (ADDR0), U7.17 (GND), U7.25 (EPAD), U10.9 (GND), U10.12 (A0), U10.13 (A1), U11.2 (GND), U11.3 (REF2), U11.7 (REF1), U69.10 (ADDR1), U69.17 (GND), U69.25 (EPAD), U73.2 (GND), U73.3 (REF2), U73.7 (REF1), U74.2 (GND), U74.3 (REF2), U74.7 (REF1), U75.2 (GND), U75.3 (REF2), U75.7 (REF1), U76.2 (GND), U76.3 (REF2), U76.7 (REF1), U77.2 (GND), U77.3 (REF2), U77.7 (REF1), U78.2 (GND), U78.3 (REF2), U78.7 (REF1), U79.2 (GND), U79.3 (REF2), U79.7 (REF1), U80.2 (GND), U80.3 (REF2), U80.7 (REF1), U81.2 (GND), U81.3 (REF2), U81.7 (REF1), U82.2 (GND), U82.3 (REF2), U82.7 (REF1), U83.2 (GND), U83.3 (REF2), U83.7 (REF1), U84.2 (GND), U84.3 (REF2), U84.7 (REF1), U85.2 (GND), U85.3 (REF2), U85.7 (REF1), U86.2 (GND), U86.3 (REF2), U86.7 (REF1), U87.2 (GND), U87.3 (REF2), U87.7 (REF1), U88.9 (GND), U88.12 (A0), U89.9 (GND), U89.13 (A1), X3.3, X38.3, X39.3, X40.3, X41.3, X42.3, X43.3, X44.3, X45.3, X46.3, X47.3, X48.3, X49.3, X50.3, X51.3, X52.3, X_1.2, X_2.2, X_3.2, X_4.2, X_5.2, X_6.2, X_7.2, X_8.2, X_9.2, X_10.2, X_11.2, X_12.2, X_13.2, X_14.2, X_15.2, X_16.2; also elsewhere on the board
unnamed: R123.1, U69.11 (ADDR0)
unnamed: R43.2, U69.21 (TWOC)
unnamed: OPA_4.2 (INA-), R85.1, R89.1
unnamed: U11.8 (IN+), X3.1
unnamed: OPA_4.6 (INB-), R86.1, R90.1
unnamed: U11.1 (IN-), X3.2
unnamed: R124.2, U11.5 (OUT)
unnamed: C261.2, R124.1, U10.1 (CH0)
unnamed: U73.8 (IN+), X38.1
unnamed: OPA_4.9 (INC-), R87.2, R91.2
unnamed: U73.1 (IN-), X38.2
unnamed: R125.2, U73.5 (OUT)
unnamed: OPA_4.13 (IND-), R88.2, R92.2
unnamed: C263.2, R125.1, U10.2 (CH1)
unnamed: U74.8 (IN+), X39.1
unnamed: U74.1 (IN-), X39.2
unnamed: R126.2, U74.5 (OUT)
unnamed: R41.2, U7.21 (TWOC)
unnamed: OPA_2.2 (INA-), R59.1, R95.1
unnamed: C265.2, R126.1, U10.3 (CH2)
unnamed: OPA_2.6 (INB-), R82.1, R96.1
unnamed: U75.8 (IN+), X40.1
unnamed: U75.1 (IN-), X40.2
unnamed: R127.2, U75.5 (OUT)
unnamed: OPA_2.9 (INC-), R93.2, R97.2
unnamed: C267.2, R127.1, U10.4 (CH3)
unnamed: U76.8 (IN+), X41.1
unnamed: OPA_2.13 (IND-), R94.2, R98.2
unnamed: U76.1 (IN-), X41.2
unnamed: R128.2, U76.5 (OUT)
unnamed: C269.2, R128.1, U10.5 (CH4)
unnamed: U77.8 (IN+), X42.1
unnamed: U77.1 (IN-), X42.2
unnamed: R129.2, U77.5 (OUT)
unnamed: OPA_3.2 (INA-), R99.1, R103.1
unnamed: C271.2, R129.1, U10.6 (CH5)
unnamed: OPA_3.6 (INB-), R100.1, R104.1
unnamed: U78.8 (IN+), X43.1
unnamed: U78.1 (IN-), X43.2
unnamed: R130.2, U78.5 (OUT)
unnamed: OPA_3.9 (INC-), R101.2, R105.2
unnamed: C273.2, R130.1, U10.7 (CH6)
unnamed: U79.8 (IN+), X44.1
unnamed: OPA_3.13 (IND-), R102.2, R106.2
unnamed: U79.1 (IN-), X44.2
unnamed: R131.2, U79.5 (OUT)
unnamed: C275.2, R131.1, U10.8 (CH7)
unnamed: C277.1, U10.10 (REFIN/REFOUT)
unnamed: C276.1, R132.2, U10.16 (VDD+)
unnamed: C278.1, U10.11 (COM)
unnamed: OPA_1.2 (INA-), R107.1, R119.1
unnamed: U80.8 (IN+), X45.1
unnamed: OPA_1.6 (INB-), R108.1, R120.1
unnamed: U80.1 (IN-), X45.2
unnamed: R133.2, U80.5 (OUT)
unnamed: C280.2, R133.1, U88.1 (CH0)
unnamed: OPA_1.9 (INC-), R109.2, R121.2
unnamed: U81.8 (IN+), X46.1
unnamed: U81.1 (IN-), X46.2
unnamed: OPA_1.13 (IND-), R118.2, R122.2
unnamed: R134.2, U81.5 (OUT)
unnamed: C282.2, R134.1, U88.2 (CH1)
unnamed: U82.8 (IN+), X47.1
unnamed: U82.1 (IN-), X47.2
unnamed: R135.2, U82.5 (OUT)
unnamed: C284.2, R135.1, U88.3 (CH2)
unnamed: U83.8 (IN+), X48.1
unnamed: U83.1 (IN-), X48.2
unnamed: R136.2, U83.5 (OUT)
unnamed: C286.2, R136.1, U88.4 (CH3)
unnamed: U84.8 (IN+), X49.1
unnamed: U84.1 (IN-), X49.2
unnamed: R137.2, U84.5 (OUT)
unnamed: C288.2, R137.1, U88.5 (CH4)
unnamed: U85.8 (IN+), X50.1
unnamed: U85.1 (IN-), X50.2
unnamed: R147.2, U85.5 (OUT)
unnamed: C290.2, R147.1, U88.6 (CH5)
unnamed: U86.8 (IN+), X51.1
unnamed: U86.1 (IN-), X51.2
unnamed: R148.2, U86.5 (OUT)
unnamed: C292.2, R148.1, U88.7 (CH6)
unnamed: U87.8 (IN+), X52.1
unnamed: U87.1 (IN-), X52.2
unnamed: R149.2, U87.5 (OUT)
unnamed: C294.2, R149.1, U88.8 (CH7)
unnamed: C295.1, U88.10 (REFIN/REFOUT)
unnamed: C296.1, R150.2, R151.2, U88.16 (VDD+)
unnamed: C297.1, U88.11 (COM)
unnamed: R151.1, U88.13 (A1)
unnamed: R153.1, U89.12 (A0)
unnamed: JP5.2, U89.4 (CH3)
unnamed: JP6.2, U89.5 (CH4)
unnamed: JP19.2, U89.1 (CH0)
unnamed: JP12.2, U89.7 (CH6)
unnamed: JP14.2, U89.2 (CH1)
unnamed: JP16.2, U89.8 (CH7)
unnamed: C299.1, U89.10 (REFIN/REFOUT)
unnamed: C300.1, R152.2, R153.2, U89.16 (VDD+)
unnamed: C301.1, U89.11 (COM)
unnamed: JP11.2, U89.6 (CH5)
unnamed: JP15.2, U89.3 (CH2)
STM32_SCL1: U7.20 (SCL), U69.20 (SCL); also elsewhere on the board
STM32_SCL2: U10.14 (SCL), U88.14 (SCL), U89.14 (SCL); also elsewhere on the board
STM32_SDA1: U7.19 (SDA), U69.19 (SDA); also elsewhere on the board
STM32_SDA2: U10.15 (SDA), U88.15 (SDA), U89.15 (SDA); also elsewhere on the board
VG_1: OPA_2.14 (OUTD), R98.1, X_7.1
VG_2: OPA_4.8 (OUTC), R91.1, X_16.1
VG_3: OPA_2.8 (OUTC), R97.1, X_8.1
VG_4: OPA_4.14 (OUTD), R92.1, X_15.1
VG_5: OPA_2.7 (OUTB), R96.2, X_4.1
VG_6: OPA_4.1 (OUTA), R89.2, X_11.1
VG_7: OPA_2.1 (OUTA), R95.2, X_3.1
VG_8: OPA_4.7 (OUTB), R90.2, X_12.1
VG_9: OPA_1.14 (OUTD), R122.1, X_5.1
VG_10: OPA_3.8 (OUTC), R105.1, X_14.1
VG_11: OPA_1.8 (OUTC), R121.1, X_6.1
VG_12: OPA_3.14 (OUTD), R106.1, X_13.1
VG_13: OPA_1.7 (OUTB), R120.2, X_2.1
VG_14: OPA_3.1 (OUTA), R103.2, X_9.1
VG_15: OPA_1.1 (OUTA), R119.2, X_1.1
VG_16: OPA_3.7 (OUTB), R104.2, X_10.1

Notes on the sheet:
RF POWER AMPLIFIER IDQ_ID CURRENT SENSOR
RF POWER AMPLIFIER BIAS VG CONTROL
RF POWER AMPLIFIER TEMPERATURE SENSING

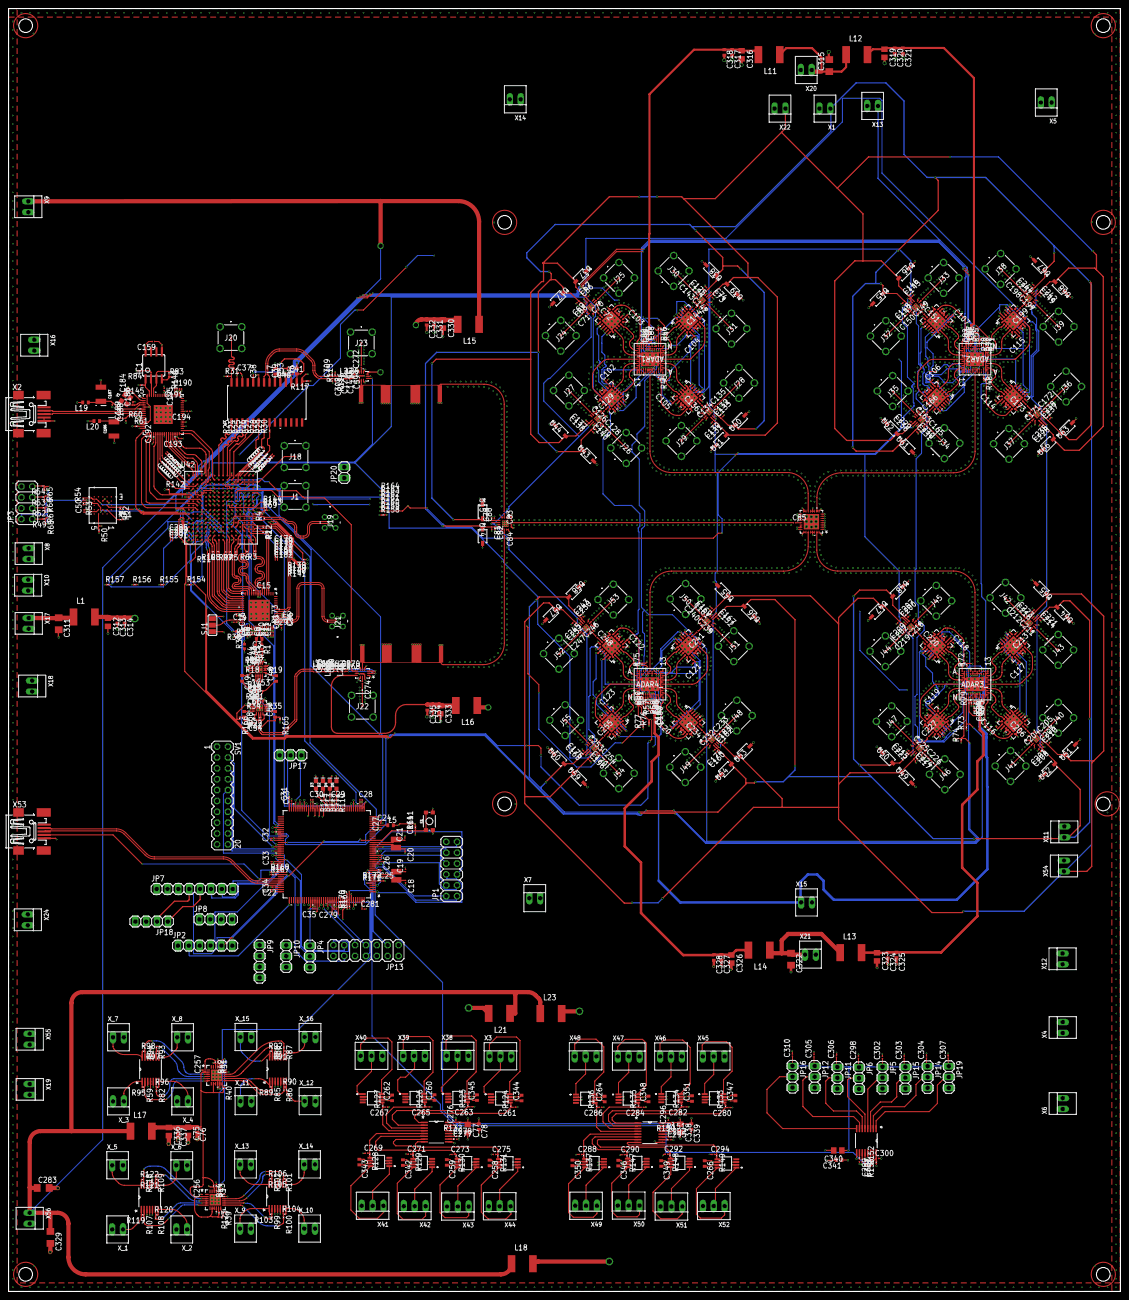
[picture p47: board RADAR_Main_Board.brd from above]

Board: 10 copper layers, 260.0 x 300.0 mm, 789 parts (0 on the bottom side), 649 nets.
