swzhangf/AERIS-10-Open-Source-Pulse-Linear-Frequency-Modulated-Phased-Array-Radar/4_Schematics and Boards Layout/4_6_Schematics/PowerAmplifierBoard/RF_PA.brd

## EAGLE design 4_Schematics and Boards Layout/4_6_Schematics/PowerAmplifierBoard/RF_PA.brd (2026-04-20)

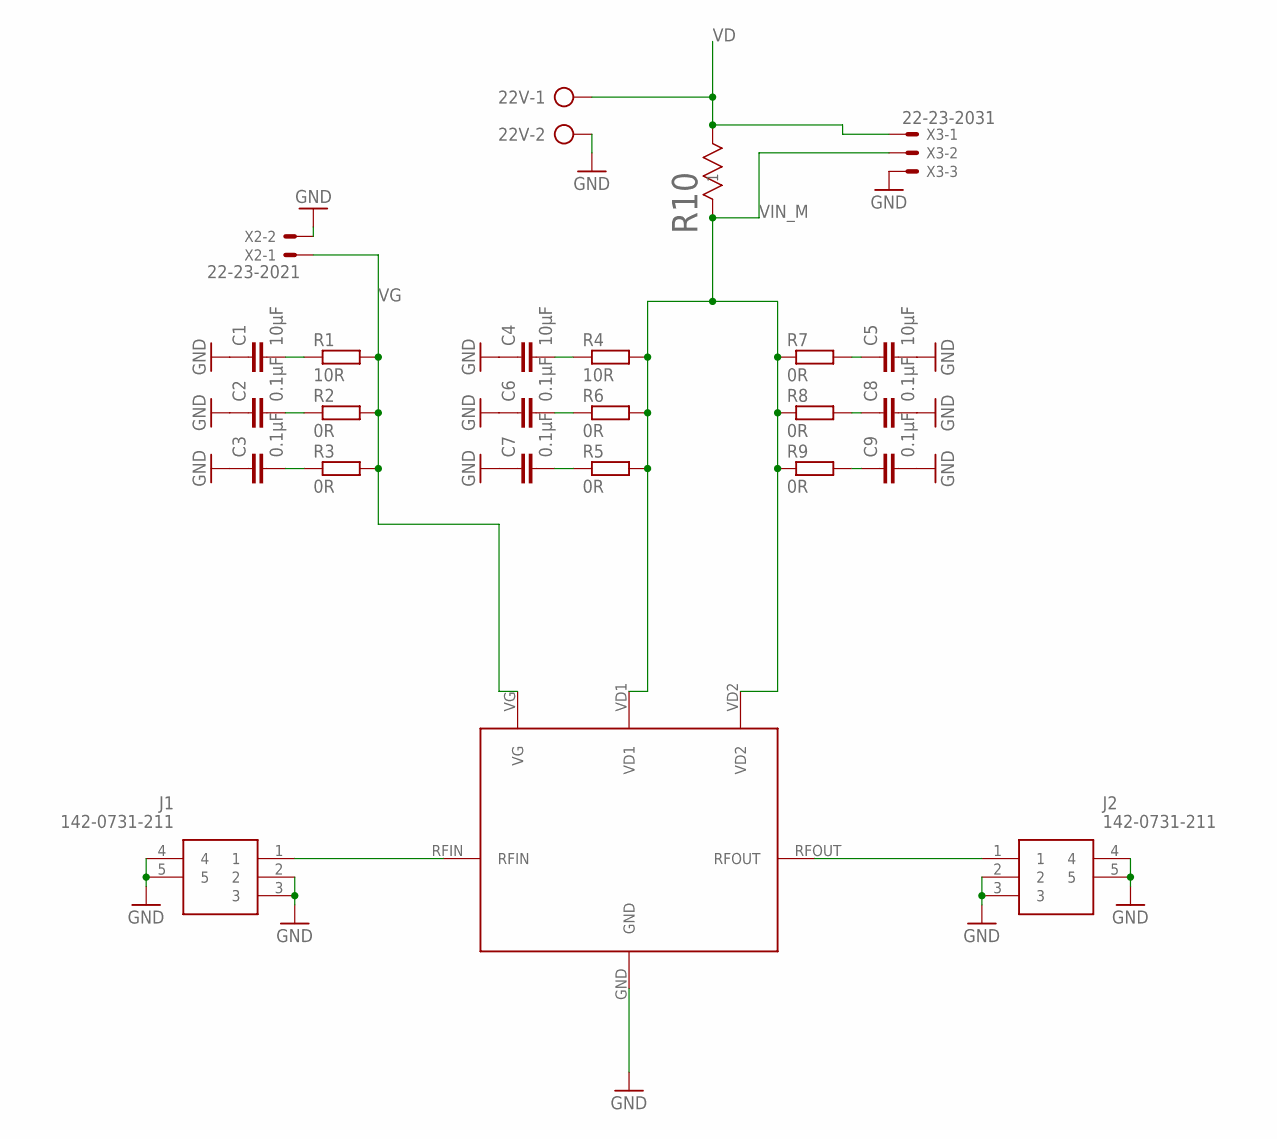
[picture p48: schematic RF_PA.sch]

Parts:
22V: AK300/2
C1, C4, C5: 10µF; C1206
C2, C3, C6, C7, C8, C9: 0.1µF; C0402
J1, J2: 142-0731-211; 1420731211
R1, R4: 10R; R0402
R2, R3, R5, R7, R8, R9: 0R; R0402
R6: 0R; R0603
R10: 5mR; WSL2816_VIS
U$1: QPA2962_B
X2: 22-23-2021
X3: 22-23-2031

Connections:
GND: 22V.2, C1.1, C2.1, C3.1, C4.1, C5.2, C6.1, C7.1, C8.2, C9.2, J1.2, J1.3, J1.4, J1.5, J2.2, J2.3, J2.4, J2.5, U$1.GND, X2.2, X3.3
unnamed: C3.2, R3.1
unnamed: J1.1, U$1.RFIN
unnamed: C1.2, R1.1
unnamed: C2.2, R2.1
unnamed: C4.2, R4.1
unnamed: C6.2, R6.1
unnamed: C7.2, R5.1
unnamed: J2.1, U$1.RFOUT
unnamed: C5.1, R7.2
unnamed: C8.1, R8.2
unnamed: C9.1, R9.2
VD: 22V.1, R10.2, X3.1
VG: R1.2, R2.2, R3.2, U$1.VG, X2.1
VIN_M: R4.2, R5.2, R6.2, R7.1, R8.1, R9.1, R10.1, U$1.VD1, U$1.VD2, X3.2

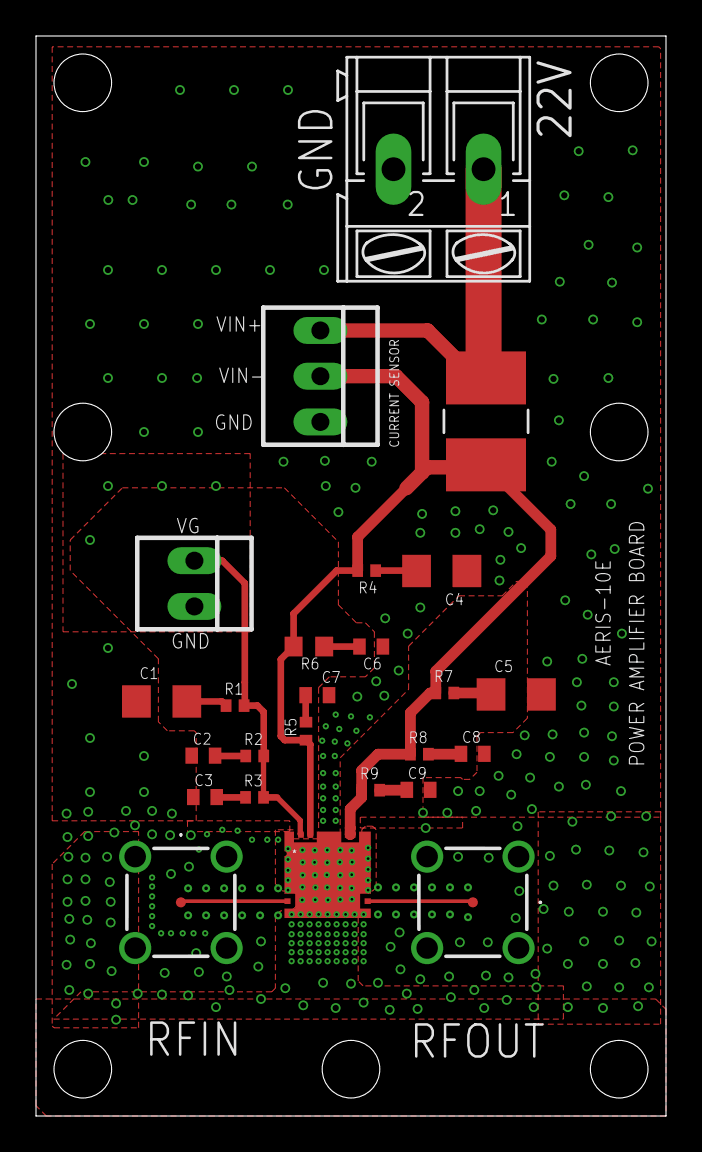
[picture p49: board RF_PA.brd from above]

Board: 4 copper layers, 35.0 x 60.0 mm, 25 parts (0 on the bottom side), 15 nets.
