swzhangf/AERIS-10-Open-Source-Pulse-Linear-Frequency-Modulated-Phased-Array-Radar/4_Schematics and Boards Layout/4_6_Schematics/Antennas/Patch/4x4/Phased_Array_Ant.brd

## EAGLE design 4_Schematics and Boards Layout/4_6_Schematics/Antennas/Patch/4x4/Phased_Array_Ant.brd (2026-04-20)

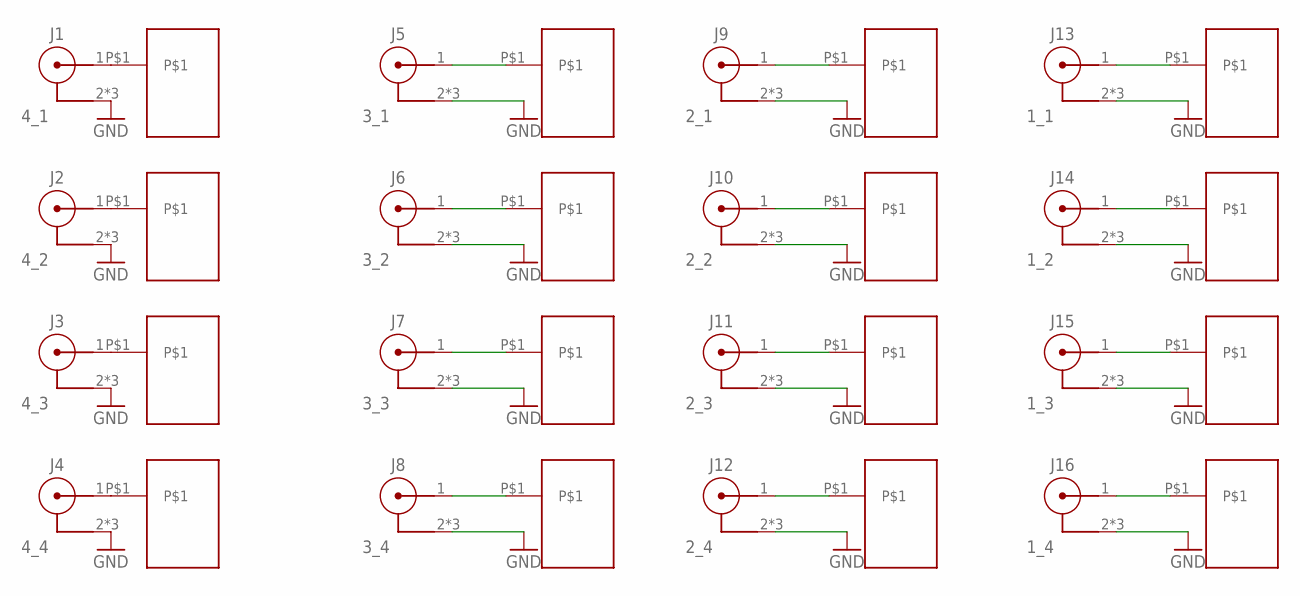
[picture p53: schematic Phased_Array_Ant.sch]

Parts:
J1: 4_1; 60124102122403
J2: 4_2; 60124102122403
J3: 4_3; 60124102122403
J4: 4_4; 60124102122403
J5: 3_1; 60124102122403
J6: 3_2; 60124102122403
J7: 3_3; 60124102122403
J8: 3_4; 60124102122403
J9: 2_1; 60124102122403
J10: 2_2; 60124102122403
J11: 2_3; 60124102122403
J12: 2_4; 60124102122403
J13: 1_1; 60124102122403
J14: 1_2; 60124102122403
J15: 1_3; 60124102122403
J16: 1_4; 60124102122403
U$1, U$2, U$3, U$4, U$5, U$6, U$7, U$8, U$9, U$10, U$11, U$12, U$13, U$14, U$15, U$16: 10.5GHZ_ANT

Connections:
GND: J1.2, J1.3 (2), J1.4 (2), J2.2, J2.3 (2), J2.4 (2), J3.2, J3.3 (2), J3.4 (2), J4.2, J4.3 (2), J4.4 (2), J5.2, J5.3 (2), J5.4 (2), J6.2, J6.3 (2), J6.4 (2), J7.2, J7.3 (2), J7.4 (2), J8.2, J8.3 (2), J8.4 (2), J9.2, J9.3 (2), J9.4 (2), J10.2, J10.3 (2), J10.4 (2), J11.2, J11.3 (2), J11.4 (2), J12.2, J12.3 (2), J12.4 (2), J13.2, J13.3 (2), J13.4 (2), J14.2, J14.3 (2), J14.4 (2), J15.2, J15.3 (2), J15.4 (2), J16.2, J16.3 (2), J16.4 (2)
unnamed: J1.1, U$1.P$1
unnamed: J2.1, U$2.P$1
unnamed: J3.1, U$3.P$1
unnamed: J4.1, U$4.P$1
unnamed: J5.1, U$5.P$1
unnamed: J6.1, U$6.P$1
unnamed: J7.1, U$7.P$1
unnamed: J8.1, U$8.P$1
unnamed: J9.1, U$9.P$1
unnamed: J10.1, U$10.P$1
unnamed: J11.1, U$11.P$1
unnamed: J12.1, U$12.P$1
unnamed: J13.1, U$13.P$1
unnamed: J14.1, U$14.P$1
unnamed: J15.1, U$15.P$1
unnamed: J16.1, U$16.P$1

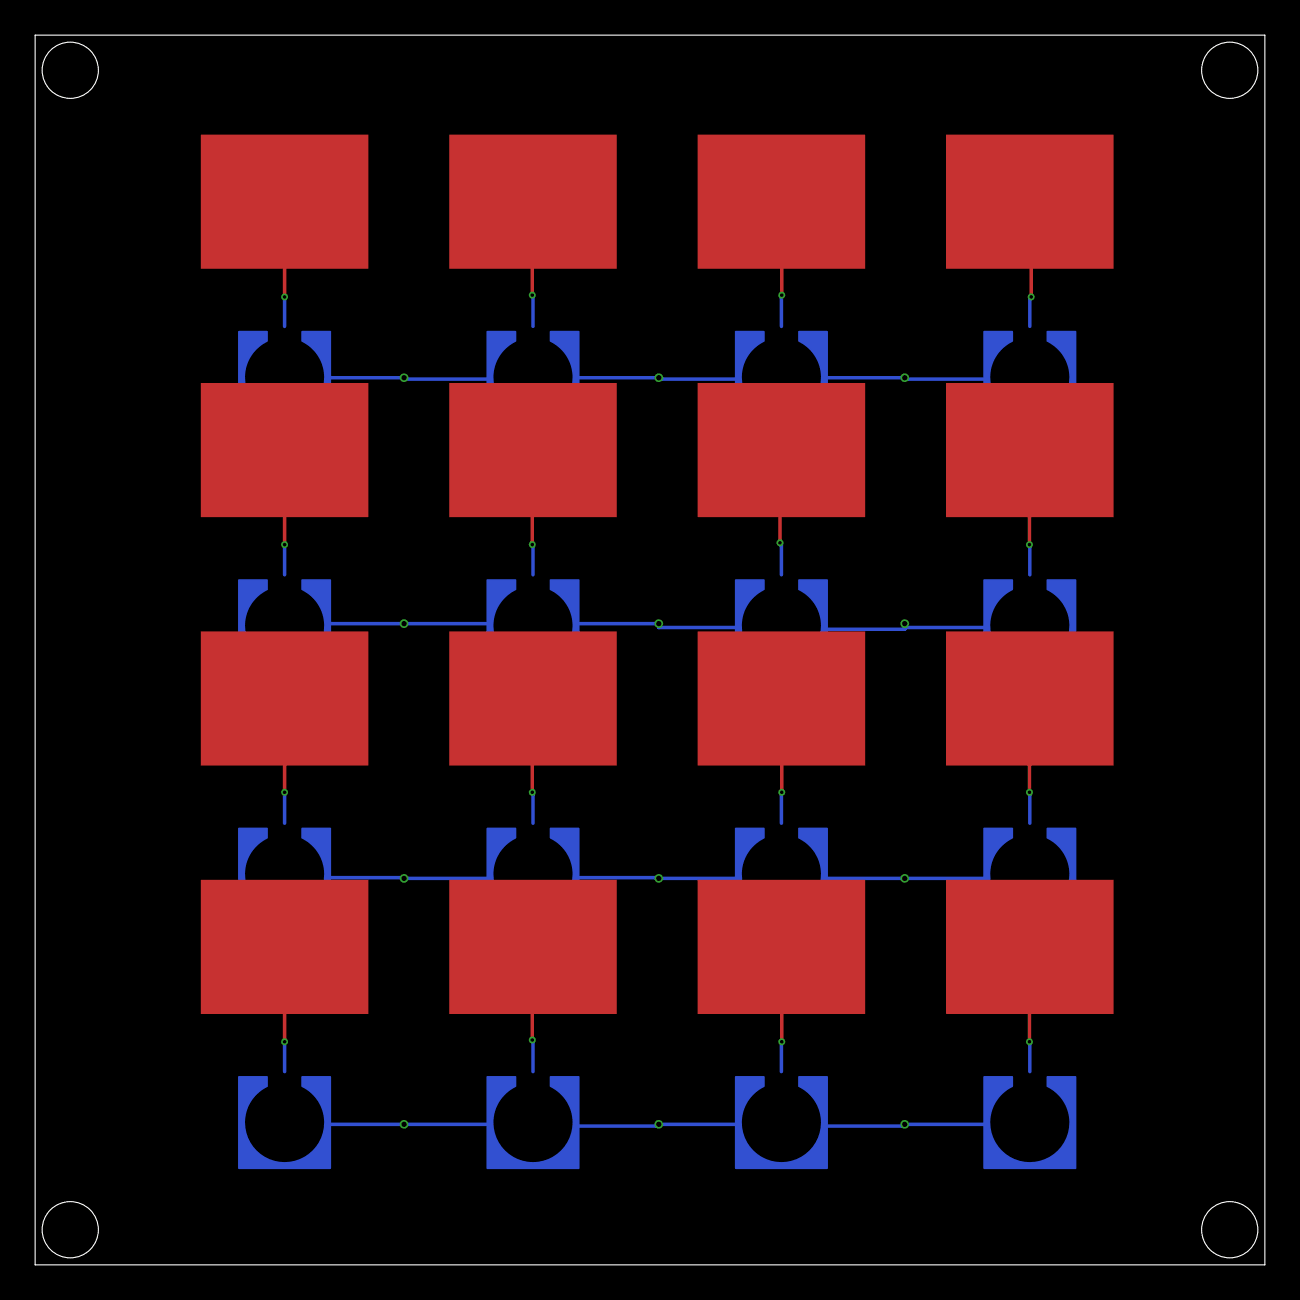
[picture p54: board Phased_Array_Ant.brd from above]

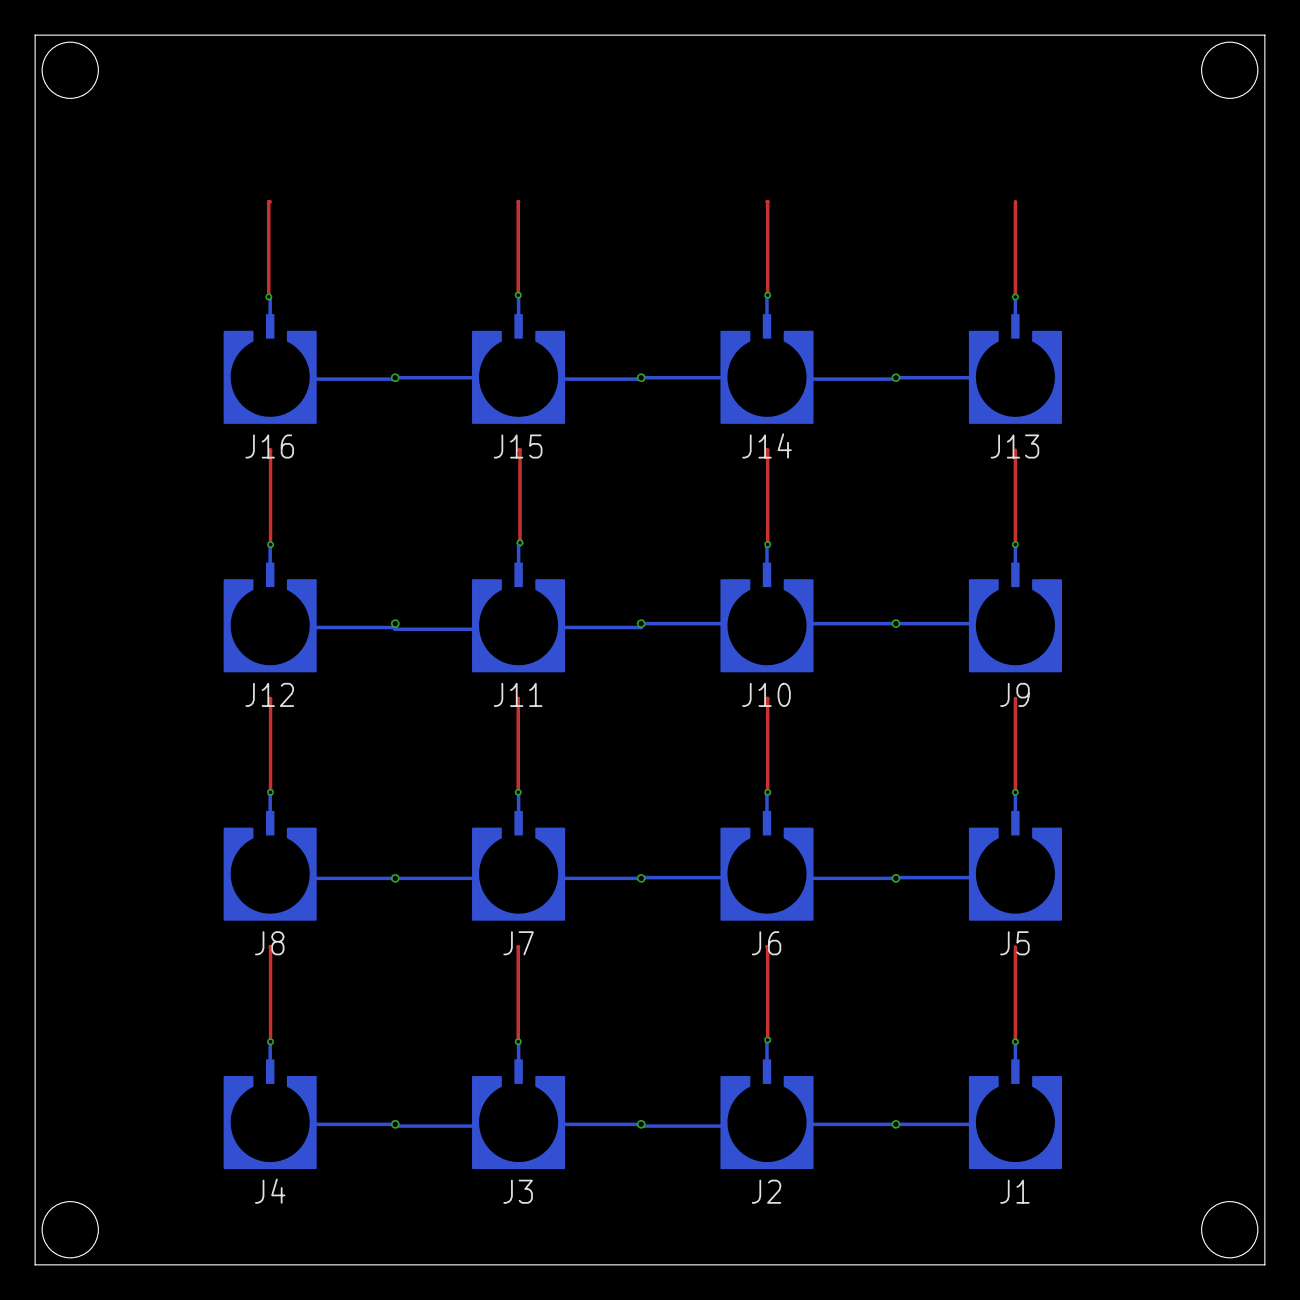
[picture p55: board Phased_Array_Ant.brd from below]

Board: 6 copper layers, 70.0 x 70.0 mm, 32 parts (16 on the bottom side), 17 nets.
