swzhangf/AERIS-10-Open-Source-Pulse-Linear-Frequency-Modulated-Phased-Array-Radar/9_Firmware/9_2_FPGA/tb/tb_chirp_controller.v

`timescale 1ns / 1ps
//////////////////////////////////////////////////////////////////////////////
// Testbench: plfm_chirp_controller_enhanced
// Tests: A5 fix (multi-driven chirp_counter removed), FSM sequencing,
//        chirp waveform output, T/R switch timing, beam scanning counters
//
// NOTE: Uses shortened timing parameters for feasible simulation.
// The real module uses T1_SAMPLES=3600, T1_RADAR_LISTENING=16440, etc.
// We override to T1=8, LISTEN=4, T2=4, GUARD=4 for fast verification.
//////////////////////////////////////////////////////////////////////////////

module tb_chirp_controller;

// =========================================================================
// PARAMETERS — shortened for simulation
// =========================================================================
parameter T1_SAMPLES         = 8;       // was 3600
parameter T1_RADAR_LISTENING = 4;       // was 16440
parameter T2_SAMPLES         = 4;       // was 60
parameter T2_RADAR_LISTENING = 4;       // was 20940
parameter GUARD_SAMPLES      = 4;       // was 21048
parameter CHIRP_MAX          = 4;       // was 32 (use 4: 2 long + 2 short)
parameter ELEVATION_MAX      = 2;       // was 31
parameter AZIMUTH_MAX        = 2;       // was 50

// =========================================================================
// CLOCK GENERATION
// =========================================================================
reg clk_120m, clk_100m;
reg reset_n;

// 120 MHz: period = 8.333 ns
initial clk_120m = 0;
always #4.166 clk_120m = ~clk_120m;

// 100 MHz: period = 10 ns
initial clk_100m = 0;
always #5 clk_100m = ~clk_100m;

// =========================================================================
// DUT SIGNALS
// =========================================================================
reg new_chirp, new_elevation, new_azimuth;
reg mixers_enable;

wire [7:0] chirp_data;
wire chirp_valid;
wire new_chirp_frame;
wire chirp_done;
wire rf_switch_ctrl;
wire rx_mixer_en, tx_mixer_en;
wire adar_tx_load_1, adar_rx_load_1;
wire adar_tx_load_2, adar_rx_load_2;
wire adar_tx_load_3, adar_rx_load_3;
wire adar_tx_load_4, adar_rx_load_4;
wire adar_tr_1, adar_tr_2, adar_tr_3, adar_tr_4;
wire [5:0] chirp_counter;
wire [5:0] elevation_counter;
wire [5:0] azimuth_counter;
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
