swzhangf/AERIS-10-Open-Source-Pulse-Linear-Frequency-Modulated-Phased-Array-Radar/(notices)

Notices in the files:
9_Firmware/9_1_Microcontroller/9_1_3_C_Cpp_Code/main.cpp:
Copyright (c) 2025 STMicroelectronics.
All rights reserved.
This software is licensed under terms that can be found in the LICENSE file
README.md:
Hardware: CERN-OHL-P
parts and their libraries:
My_Library_RADAR: COPYRIGHT: Copyright (C) 2025 Ultra Librarian. All rights reserved.
SparkFun-LED: Licensing: Creative Commons ShareAlike 4.0 International - https://creativecommons.org/licenses/by-sa/4.0
COPYRIGHT: Copyright (C) 2024 Ultra Librarian. All rights reserved.
